user1145141919450/pynq-particle-magnetic-trace/board/README.md

# board/ — 上板包

`deploy/` 内含交付 bit、HWH 与板端运行脚本；复制到板端 `/home/xilinx/wp/` 后按设计报告 §5.1 运行。
