user1145141919450/pynq-particle-magnetic-trace/data/docs/ext_board_schematic.md

# PYNQ-Z2 演示控制拓展板 · 原理图 v1.2

**用途**：把比赛演示需要的外设集中到一块小板上 —— OV5640 摄像头（DVP）与
两个电位器（RV1 调磁场 B → AIN0、RV2 调速度 V → AIN1，共用一颗 PCF8591），
插在 PYNQ-Z2 的 PMOD 与 Arduino 盾板排母上，
**v1.2 修正（2026-09-15，按官方手册 PYNQ-Z2 Reference Manual v1.0 §17 校正）**：
I2C 接盾板 J3 排母第 9/10 针（AR_SDA=P16 / AR_SCL=P15），原 AR6/AR7 是 J4 上
的普通 IO 脚，不能用；A0~A5 经三方对质（手册称 XADC 模拟输入 vs R12 原理图+
官方板卡文件显示现产板为 bank13 普通数字脚、板卡文件无任何 XADC 通道）裁决：
**以现产板为准，A0~A5 不是 ADC，PCF8591 方案不变**。
替代现在的杜邦线飞线。**按键 B+/B- 不用拓展板**：改用板载 BTN0~BTN3
（LED 区下方 4 个板载按键，直通 PL，2026-09-14 用户确认）。

**引脚事实来源**：
- 摄像头 16 根信号：`build/vivado/ov5640_pynq/constrs/ov5640_pynq.xdc`（已上板验证，权威）
- Arduino 排针：Vivado 板卡文件 `pynq-z2/A.0/part0_pins.xml`（AR0~AR13，权威）
- **注意**：板卡文件里 PYNQ-Z2 **没有 XADC 接口**（A0~A5 是普通 LVCMOS33 数字脚），
  故电位器走外置 ADC（PCF8591），不走 XADC。

---

## 1. 系统框图

```
                        拓展板 (ext_board v1.0)
   PYNQ-Z2        ┌─────────────────────────────────────────┐
  ┌─────────┐     │  P1 (JA 插头)  ── D0..D7 ──────────┐     │
  │ PMOD JA │═════│  P2 (JB 插头)  ── pclk/href/vsync │     │
  │ PMOD JB │═════│                ── xclk/rst/pwdn   │     │
  │         │     │                ── scl/sda ────────┼──┐  │
  │ Arduino │     │  P3 (盾板 J3 排母 9/10 针) ─ SDA/SCL ┼─┼──┼─→ U1 PCF8591
  │  盾板区 │═════│                                   │  └─┤     ↑ AIN0←RV1(B)
  └─────────┘     │  J1 摄像头插座(2x9 母) ────────────┘    │     ↑ AIN1←RV2(V)
                  │  18pin OV5640 DVP 模块                  │    10kΩ×2
                  │  供电 3.3V（板载 LDO，已跑通）           │
                  └────────────────────────────────────────┘
   ★ 按键 B+/B- = 板载 BTN1/BTN2（不占拓展板），见 §7
```

## 2. 网络表 —— P1（PMOD JA，摄像头数据）

PMOD 12 针排母定义（Digilent 标准）：pin1~4、7~10 为信号，pin5/11=GND，pin6/12=3V3。

| 拓展板 P1 针 | PYNQ JA 针 | 网络名 | FPGA 球号 | 去向 (J1) |
|---|---|---|---|---|
| 1 | JA1 | DVP_D0 | Y18 | 模块 D0 |
| 2 | JA2 | DVP_D1 | Y19 | 模块 D1 |
| 3 | JA3 | DVP_D2 | Y16 | 模块 D2 |
| 4 | JA4 | DVP_D3 | Y17 | 模块 D3 |
| 5 | — | GND | — | 模块 GND |
| 6 | — | 3V3 | — | 模块 3V3 |
| 7 | JA7 | DVP_D4 | U18 | 模块 D4 |
| 8 | JA8 | DVP_D5 | U19 | 模块 D5 |
| 9 | JA9 | DVP_D6 | W18 | 模块 D6 |
| 10 | JA10 | DVP_D7 | W19 | 模块 D7 |
| 11 | — | GND | — | 模块 GND |
| 12 | — | 3V3 | — | 模块 3V3 |

## 3. 网络表 —— P2（PMOD JB，摄像头控制/时序）

| 拓展板 P2 针 | PYNQ JB 针 | 网络名 | FPGA 球号 | 去向 (J1) |
|---|---|---|---|---|
| 1 | JB1 | DVP_PCLK | W14 | 模块 PCLK |
| 2 | JB2 | DVP_HREF | Y14 | 模块 HREF |
| 3 | JB3 | DVP_VSYNC | T11 | 模块 VSYNC |
| 4 | JB4 | DVP_XCLK | T10 | 模块 XCLK (24MHz) |
| 5 | — | GND | — | 模块 GND |
| 6 | — | 3V3 | — | 模块 3V3 |
| 7 | JB7 | DVP_RST_N | V16 | 模块 RESET |
| 8 | JB8 | DVP_PWDN | W16 | 模块 PWDN |
| 9 | JB9 | DVP_SCL | V12 | 模块 SCL |
| 10 | JB10 | DVP_SDA | W13 | 模块 SDA |
| 11 | — | GND | — | 模块 GND |
| 12 | — | 3V3 | — | 模块 3V3 |

（与 XDC 完全一致：JA1..JA4/JA7..JA10 数据、JB1..JB4/JB7..JB10 控制。
SDA 上拉：FPGA 已开 PULLUP，模块板自带，拓展板可再留 4.7k 焊盘各一，默认不焊。）

## 4. 网络表 —— P3（Arduino 盾板排母区，ADC）

**v1.2 修正（手册 §17 表 16/17 权威值）**：盾板区共 4 排母座——J1（6 针 A0~A5）、
J7（8 针电源 5V/3.3V/GND/RST）、J3（10 针：AR8~AR13 + **第 9 针 AR_SDA=P16、
第 10 针 AR_SCL=P15**）、J4（8 针 AR0~AR7）。**I2C 必须用 J3 第 9/10 针**（板上
丝印 SDA/SCL 就是这俩）；AR0~AR13 其余脚（板卡文件 `arduino_a0_a13_tri_i_0..13`）
都是普通 IO。P16/P15 板卡文件未收录，XDC 用裸球号约束（loc="P16"/"P15"）。

| 拓展板 P3 针 | PYNQ 盾板针位 | 网络名 | FPGA 球号 | 去向 |
|---|---|---|---|---|
| 1 | J3 第 9 针（丝印 SDA） | ADC_SDA | P16 | U1 PCF8591 pin9 (SDA) |
| 2 | J3 第 10 针（丝印 SCL） | ADC_SCL | P15 | U1 PCF8591 pin10 (SCL) |
| 3 | J7 任一 GND 针 | GND | — | 参考地 |

ADC 的 SCL/SDA 上拉：FPGA PULLUP（I2C 速率 ≤100kHz，够用）。
J4 的 AR0~AR7、J3 的 AR8~AR13 留空 —— 日后若要外接长线抓拍按钮可挂这里。
**A0~A5 不用于模拟**：手册 v1.0 称其为 XADC 模拟输入，但 R12 原理图 FPGA 符号与
官方板卡文件一致显示现产板 A0~A5 为 bank13 普通 LVCMOS33 数字脚、板卡文件无
任何 XADC 通道 —— 以现产板为准，电位器走外置 PCF8591，不赌 XADC。

## 5. J1 —— OV5640 模块 18P 插座（2×9 母座）

模块侧 16 根信号 + 3V3 + GND。**排针定义以你的模块丝印/说明为准**，
市面常见两种排法（二选一，画板时照你的模块定）：

排法 A（最常见，VCC 在 1 脚）：
```
 1 VCC3V3    2 GND
 3 SCL       4 SDA
 5 VSYNC     6 HREF
 7 PCLK      8 XCLK
 9 D7        10 D6
11 D5        12 D4
13 D3        14 D2
15 D1        16 D0
17 RESET     18 PWDN
```
排法 B（部分批次，GND 在 1 脚）：
```
 1 GND    2 VSYNC
 3 HREF   4 SCL
 5 SDA    6 PCLK
 7 XCLK   8 RESET
 9 PWDN   10 D0
11 D1     12 D2
13 D3     14 D4
15 D5     16 D6
17 D7     18 VCC3V3
```
判定方法：用万用表通断档量模块板 —— 与电解电容/稳压芯片相连且走线宽的
一根是 3V3；与敷铜大面积相连的是 GND。找到这两根，对照上表即可定排法。

## 6. 电位器 + PCF8591 电路

```
   3V3 ──┬──────────────────────────────┐
         │ (100nF 去耦)                 │
        ─┴─ C1            U1 PCF8591 (DIP16)  A0/A1/A2 全部接地 → I2C 地址 0x48
         │             ┌────────────────┐
   RV1 10kΩ 电位器(B)   │1 AIN0  VDD 16──┤── 3V3
   一端─3V3 一端─GND     │2 AIN1  AOUT 15  │   (空)
   滑动端→AIN0(pin1)     │3 AIN2  VREF 14──┤── 3V3 (满量程基准)
   RV2 10kΩ 电位器(V)   │4 AIN3  AGND 13──┤── GND
   接法同 RV1            │5 A0    EXT 12───┤    (空)
   滑动端→AIN1(pin2)     │6 A1    OSC 11───┤    (空)
                        │7 A2    SCL 10───┼── ADC_SCL → P3 针2
                        │8 VSS   SDA 9────┼── ADC_SDA → P3 针1
                        └────────────────┘
   AIN2~AIN3 留焊盘（日后可加钮）
   I2C 速率 ≤100kHz；VREF=VDD=3.3V → 满量程 0~3.3V，8 位 256 级，调 B/V 足够。
```

## 7. 按键（板载 BTN0~BTN3，不在拓展板上）

PYNQ-Z2 板载 4 个按键（LED 区）直通 PL，无需任何外部器件（板卡文件权威值）：

| 按键 | FPGA 球号 | 电平 | 本设计用途 |
|---|---|---|---|
| BTN0 | D19 | 按下=高 | 抓拍键（原设计已定） |
| BTN1 | D20 | 按下=高 | **B+（磁场增强，每按一次加一档）** |
| BTN2 | L20 | 按下=高 | **B-（磁场减弱，每按一次减一档）** |
| BTN3 | L19 | 按下=高 | 备用（如 B 归零/清轨迹） |
| SW0 | M20 | 拨=高 | 备用（如：电位器/按键选源） |
| SW1 | M19 | 拨=高 | 备用 |

注意：板载按键**按下=高电平**（板上有上拉网络，XDC 无需 PULLUP）；
PL 侧 2-FF 同步 + 20ms 消抖 + 上升沿触发。演示时板子放在手边即可单手按 BTN1/2。

## 8. BOM

| 位号 | 元件 | 规格 | 数量 | 备注 |
|---|---|---|---|---|
| U1 | PCF8591 | I2C 8bit ADC，DIP16 | 1 | 或 SOP16 转接 |
| RV1 | 电位器（调 B） | **Bourns PTV09A-4015F-B103**（或 -4020U-B103） | 1 | B 型线性 10kΩ；4015/4020=柄长 15/20mm，两者皆可 |
| RV2 | 电位器（调 V） | **Bourns PTV09A-4015F-B103**（或 -4020U-B103） | 1 | 同上。**选型要点：B 型=线性**（A 型对数不可用于调参数量）；103=10kΩ；到货用万用表验：中点≈总阻值一半 |
| C1 | 去耦电容 | 100nF | 1 | |
| P1/P2 | 排针插头（对插 PMOD） | 2×6 弯针公头 | 2 | 方向按实物定 |
| P3 | 排针插头 | 1×3 弯针公头（或杜邦线座） | 1 | SDA/SCL/GND |
| J1 | 摄像头插座 | 2×9 母座（或直接焊杜邦线座） | 1 | 2.54mm |
| R1/R2 | 上拉电阻焊盘 | 4.7kΩ | 2 | 默认不焊（见 §3） |

（按键不在 BOM 里 —— 用板载 BTN0~BTN3，见 §7。）

## 9. 设计说明与注意事项

1. **共地**：P1/P2/P3 的 GND 在拓展板上必须连成一个地平面；按键与 ADC 都
   参考这个地。
2. **供电**：摄像头 3V3 取自 PMOD（现状已跑通，模块板载 LDO）；
   ADC+电位器 3V3 同样取自 PMOD 3V3（电流 <1mA，无压力）。
3. **XADC 说明**：部分批次 PYNQ-Z2 的 A 区脚可能有 XADC 辅通道（论坛有
   A5→VAUX13 的讨论），但官方板卡文件未声明、不可依赖。本设计不赌它；
   若日后想验证，可在拓展板留一个 A0 测试点（不影响本设计）。
4. **物理可分**：摄像头部分（P1/P2/J1）与 ADC 部分（P3/PCF8591/RV）电气完全独立——摄像头只占 PMOD、ADC 只占 Arduino 排针。两种实物做法等效：①一体板（本原理图，含摄像头插座+ADC）②分开（摄像头维持已验证杜邦线不动 + 电位器/PCF8591 单独面包板或洞洞板），接线表不变。
5. **后续实现（PL/PS 侧，M1b 阶段做）**：
   - ADC：在 PL 再例化一个 I2C 主机（复用已验证的 `ov5640_iic.v`，挂在
     AR7/AR6），按固定节拍读 PCF8591 通道 0（B）与通道 1（V）→
     两个 32 位寄存器 → axi_gpio → PS。
   - 按键：板载 BTN0~BTN3 直通 PL（D19/D20/L20/L19，按下=高），2-FF 同步 +
     20ms 消抖 + 上升沿 → axi_gpio → PS；XDC 用板卡预设、LVCMOS33。
   - 演示逻辑：BTN0=抓拍；BTN1/BTN2 按一次 B 加/减一档（长按可连续加）；
     电位器值 + 按键增量共同决定 B 的设定值（B = clamp(B_base + pot_delta +
     Σ按键步进)）。
