user1145141919450/pynq-particle-magnetic-trace/data/README.md

# data/ — 数据与原始报告

- `docs/`：构建/迁移、演示、规则等项目文档；
- `reports/`：净室构建、板上验收等实测报告；
- `evidence/`：交付 bit 与 2026.1 迁移 bit 的原始时序/资源 .rpt；
- `captures/`：实拍采集数据。
