user1145141919450/pynq-particle-magnetic-trace/sim/README.md

# sim/ — 仿真

`tb/` 含 13 个 testbench；`run_v3_sim.sh` / `run_map_detect_sim.sh` 可直接运行；详细对拍口径见设计报告 §3.1。
