user1145141919450/pynq-particle-magnetic-trace/report/photos/README.md

# photos/ —— 报告用图与原始照片

## 报告用图

| 文件 | 用在 |
|---|---|
| `seewo_fig.jpg` | 图 1 课堂演示（希沃大屏） |
| `props_wide.jpg` | 图 3 实体摆件（横向） |
| `serial_pair.jpg` | 图 4 串口屏（(a) 状态页 + (b) 加球选色页） |
| `serial_hmi_editor.jpg` | 图 5 串口屏开发界面（USART HMI） |
| `hdmi_fig.jpg` | 图 6(a) HDMI 实拍叠加与轨迹 |
| `web_fig.png` | 图 6(b) 平板网页对局页（原生截图） |
| `hardware_montage_fig.jpg` | 图 7 硬件模块（摄像头转接板/照明/MTT USB 坞，键鼠/网卡） |
| `vivado_bd.pdf` | 完整 Vivado BD（矢量，可放大） |

## 原始照片

| 文件 | 内容 |
|---|---|
| `seewo.png` | 希沃课堂演示原图 |
| `setup_wide.jpg` | 桌面全景（键鼠、平板、串口屏、实体件） |
| `props_closeup.jpg` | 实体摆件原图 |
| `serial_status.jpg` / `serial_addball.jpg` | 串口屏状态页 / 加球选色页原图 |
| `hdmi_screen_crop.jpg` / `web_ui_crop.jpg` | HDMI 画面 / 平板网页裁图 |
| `camera_adapter.jpg` | OV5640 摄像头转接板 |
| `lighting_module.jpg` | 照明模块（相机补光） |
| `usb_hub.jpg` | MTT USB 扩展坞 |

照片只用于作品说明，不含个人信息或凭据。

## 2026-11-02 新增（图 5、图 6）

| 文件 | 内容 |
|---|---|
| `hdmi_new.jpg` | HDMI 屏幕实拍原图（新） |
| `web_new.png` | 平板网页对局页截图（新，原生分辨率） |
| `serial_hmi_editor.jpg` | 图 5 串口屏 USART HMI 编辑界面（1400×836） |
| `hdmi_fig.jpg` | 图 6(a) HDMI 裁切图（1070×580） |
| `web_fig.png` | 图 6(b) 平板网页图（1280×889，未缩放） |
| `serial_pair.jpg` | 图 4 串口屏两联图（状态页 + 加球选色页） |
| `run_small.jpg` / `run_raw_new.jpg` | 旧版图 6 两联图（已不再引用，仅存档） |
