user1145141919450/pynq-particle-magnetic-trace/data/docs/demo_script_3min.md

# 三分钟台本 · 2026-10-31 晚

> ⚠ **上镜前必做**：本文里的 6.7ms / 1.6s / 240× 是旧稿数字，与板上另一次实测
> （6.09ms / 1427ms / 234×）不一致。**开拍前用当时那块 bit 重测一次，全套数字统一**
> 用那一轮的结果，再回来改本文。说错数字比说漏更糟。
> 重测命令（板上）：`./v3_shoot.sh --cam`（读它打印的 PL 一簇耗时与 PS 串行耗时）。

---

## 开场前摆好（不上镜的部分）

- 红球、蓝球各一颗，放在桌边（换球用）
- 黑条一根、绿门两扇、黑球一个，**开局就摆在场区里**（它们是"免费基线"，不用买不用摆）
- 手机架好、串口屏朝镜头

---

## 台本

**[0:00]** （手里拿着球）

这个球，我们当成带电粒子。

（把球放到桌上）

放上去，它一停稳，屏幕上就把它圈出来、编号。这一步是相机识别，还没到 FPGA。

**[0:15]** （指着屏幕）

这条绿线是我瞄的方向。旁边这一排小点，是 17 条轨迹各自的结局——绿的能从这个洞出去，灰的打回来了。

（按空格）

走。

（等）

进了。屏幕上这一下，是 17 条路**同时**算出来的，在一块 FPGA 上，6.7 毫秒。

同样这 17 条，CPU 一条一条算，要 1.6 秒。差 240 倍。

而且不是"看起来对"：这 17 条结果，跟我们自己的软件模型逐条对过，一条不差。

**[0:50]** 再打一枪，这次故意偏一点。

（按空格）

你看，没进，打回来了。那些灰点就是撞墙回来的——17 条各算各的，才有这一绿一灰的区别。

**[1:05]** （换蓝球进场）

下面这个我们最喜欢。红的是正的，蓝的是负的。

（红蓝各打一颗，让它们对撞）

等它们撞上——（等）——看，一起没了。正负相消，闪个白圈。

这是规则里写的物理，不是特效。

**[1:30]** （指场上的黑条、绿门、洞口）

场上我已经摆好了黑条、一对绿门、一个洞口。

（打一杆）

球撞黑条弹开，进绿门从另一头出来，最后从这个新洞口出射。

障碍、传送门、洞口——一杆全过。

**[1:50]** （切到局前商店）

道具是买的，五种，用积分买。

（选一个，按 E）

买了，积分少一截。买完现场摆，**确认才生效，不确认不扣**。

**[2:10]** （改磁场，连改两次）

磁场也能改：选块、定方向、输数值，三步确认。

（改第一次）

改一次，它重算一次 17 条。

（改第二次）

再改一次，又重算一次。每次 6.7 毫秒——你改多快它算多快。

**[2:40]** （收）

所以这个东西就两件事：

**算**，在一块 FPGA 上，17 条路同时算，6.7 毫秒，跟软件逐位对得上；

**玩**，它是一副两个人能坐下来打的游戏，有积分、有道具、有洞口。

就这些。

---

## 怎么演（镜头纪律）

| 段落 | 镜头 | 忌讳 |
|---|---|---|
| 放球 | 手 + 桌子，别拍屏幕 | 别一上来就怼屏幕 |
| 打杆 | 屏幕，**等判定出现**再开口 | 别边打边说话，评委听不清 |
| 多球 | 屏幕，等湮灭那一下 | **别现场试角度**，排练时定好 |
| 一杆多效 | 屏幕 + 手（摆好了不用手） | 别在这段解释道具怎么买 |
| 商店 | 屏幕特写 | 别念菜单 |
| 改磁场 | 键盘手部 + 屏幕（同框） | 别背对镜头挡屏 |

---

## ⚠ 开拍前必须核实的三条（核完再定稿）

1. **数字统一**：跑 `./v3_shoot.sh --cam`，把 PL 一簇耗时 / PS 串行耗时 / 倍数
   记下来，全文换成这一轮的实数（现稿 6.7ms/1.6s/240× 与板上另一次实测
   6.09ms/1427ms/234× 不一致，不能就这么说）。
2. **场区到底有什么**：默认场区种子（seed 7）自带「3 块磁场 + 左右两洞」，而
   [1:30] 写的是「我摆了一根黑条、一对绿门、一个洞口」。**实跑一眼看屏幕**，
   按屏幕上真实出现的件数与位置改这段——说错件数比少说更糟。
   看启动那行 `[V3] 场区：块=? 洞=[...]`，以及屏幕上实际画出的障碍/门/洞。
3. **黑条/绿门/洞口是不是开局就免费**：源码里写的是"开局就在桌上的实体件是免费
   基线，不受购买门限制"，但**要在板上实跑确认**（尤其洞口）。

---

## 排练必须解决的三件事

1. **进洞那一杆的角度**：提前找到能进的那一枪，写下来（角度/球位），现场照打
2. **红蓝对撞的角度**：两颗球要能撞上，排练时试出来
3. **连改磁场的手速**：两次改动之间别停超过 3 秒，让评委看到"改一次算一次"

---

## 卡住了就说的三句

- 球没识别：「它要停稳才发号」→ 拿起来再放下
- 画面卡：「卡的是摄像机画面，计算从来没卡过——6.7 毫秒」
- 按错：「三步确认，每一步都能退」→ `ESC`

---

## 如果只剩 60 秒

打一杆（进洞）+ 多球湮灭 + 一句收口：

> 「17 条路同时算，6.7 毫秒，比 CPU 快 240 倍，跟软件逐位对得上；它还是个能打的游戏。」
