user1145141919450/pynq-particle-magnetic-trace/data/docs/project_intro_2026-10-25_final.md

# 项目介绍（2026-10-25 定稿）

> **用户定稿：这段文字不再改动。**
> 字数实测：**含换行/空行 495 字，不含换行 489 字**（≤500）。
> 对外介绍按正文；正文没展开的分工与边界见文末“答辩口径”。

本项目基于PYNQ搭建双人对抗式粒子磁迹演示装置，聚焦带电粒子磁场偏转、临界出射与多电荷交互规律。系统通过摄像头映射实体桌面与虚拟磁场，两名玩家可调节粒子入射速度、角度与分块磁场参数，操控正负电子射出边界缺口完成得分。

本项目核心优势为FPGA硬件并行，区别于单片机、软件仿真的串行迭代模式，采用多路硬件几何运算流水线，并行完成17路轨迹束与障碍/门判定；系统另集成8粒PL粒子引擎，演示多体碰撞与电荷交互，实现同种电荷反弹、异种电荷湮灭与实体碰撞。轨迹束求解与判定一次完成，系统真实还原多粒子耦合过程。

用户可现场摆放实体件自定义地形，红球为正电荷、蓝球为负电荷、黑球为洞口标记，黑条反射障碍、绿椭圆传送门，形成出题、对抗、复盘的完整教学闭环，并搭配串口屏、HDMI与手机端实时反馈。系统采用梯度关卡、逐局增加分区与积分兑换道具。HDMI实时叠加17路瞄准轨迹束与真球轨迹，串口屏与手机端同步对局参数；PL轨迹束一次扫描17路微扰，直观呈现临界分界。

采用PS/PL异构，PL完成候选检测、17路轨迹束与障碍/门判定，集成8粒粒子引擎；ARM负责对战逻辑、积分道具、交互与候选复判。

---

## 答辩口径（正文没写的，被问再答）

- **主对局多球碰撞/异种电荷湮灭在 PS** `realtime_ball`；PL 负责 17 路轨迹束、候选检测、障碍/门判定与 16 粒 PL 粒子引擎（可选/风暴演示）。
- **classify 仍在 PS**；只说“PL 出候选”，**不说“整条检测链在 PL”**。
- **17 路轨迹束当前是 2 条物理 lane 时间复用**，相对 PS 串行约 **22×**（534ms→~24ms）；不说“17 路并行硬件”。
- **HDMI 默认去 HUD**（`SCREEN=1` 默认 `--no-hud`）；参数在串口屏/手机；需要 HDMI 参数可 `HUD=1`。
- **没有 LED 灯光**；反馈是串口状态屏 + HDMI 画面 + 手机端。
- **“复盘”是能力**：进球会生成 6s 复盘图（`--v3-review`），手机有最近一杆/轨迹；平时不常放，答辩按能力说，不现场承诺展示复盘图。
