user1145141919450/pynq-particle-magnetic-trace/report/photos/camera_adapter.jpg

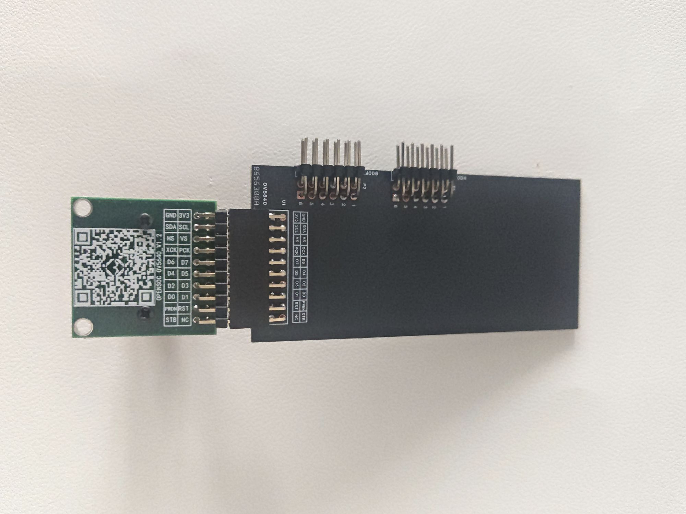
report/photos/camera_adapter.jpg
