user1145141919450/pynq-particle-magnetic-trace/report/photos/hdmi_new.jpg

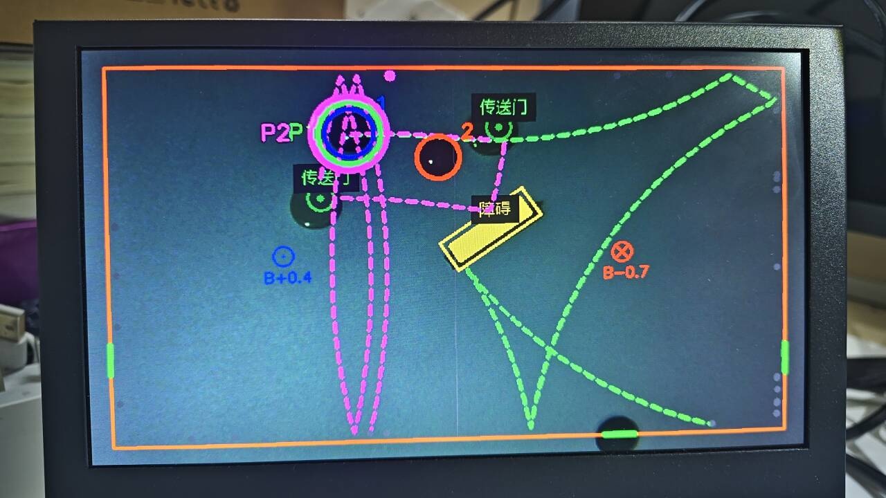
report/photos/hdmi_new.jpg
