user1145141919450/pynq-particle-magnetic-trace/report/photos/hdmi_screen_crop.jpg

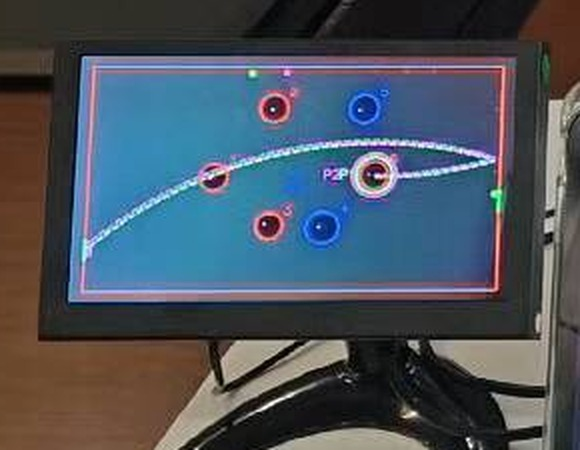
report/photos/hdmi_screen_crop.jpg
