user1145141919450/pynq-particle-magnetic-trace/report/photos/lighting_module.jpg

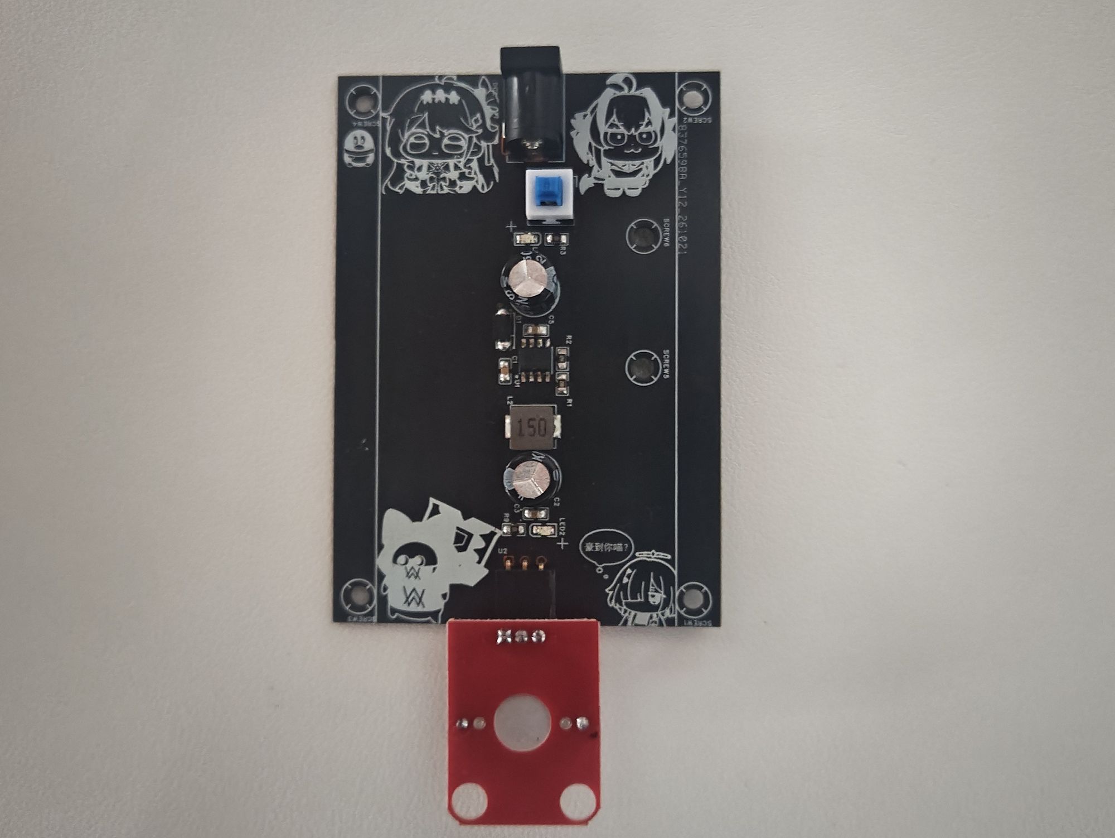
report/photos/lighting_module.jpg
