user1145141919450/pynq-particle-magnetic-trace/report/photos/props_closeup.jpg

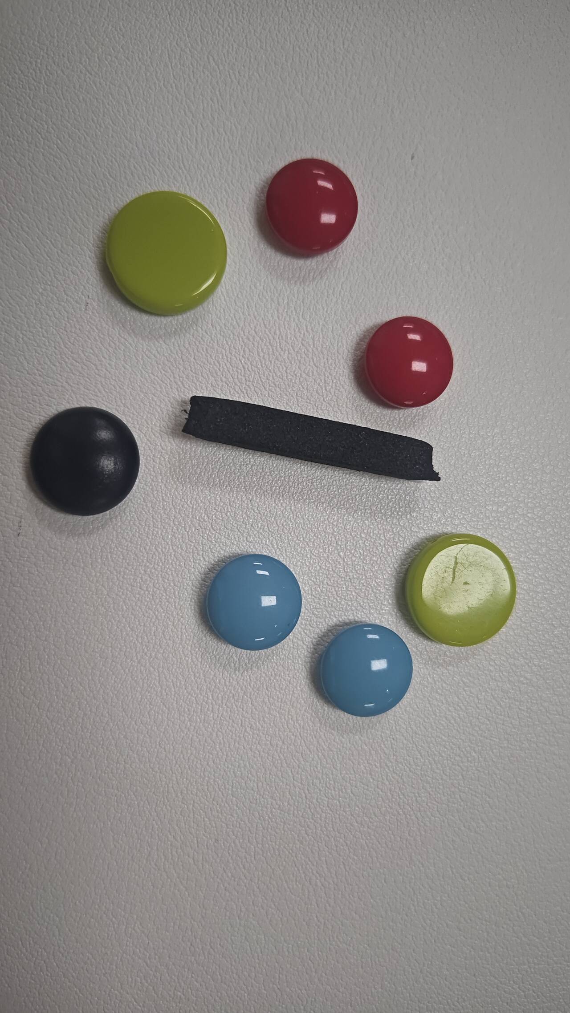
report/photos/props_closeup.jpg
