user1145141919450/pynq-particle-magnetic-trace/report/photos/props_full.jpg

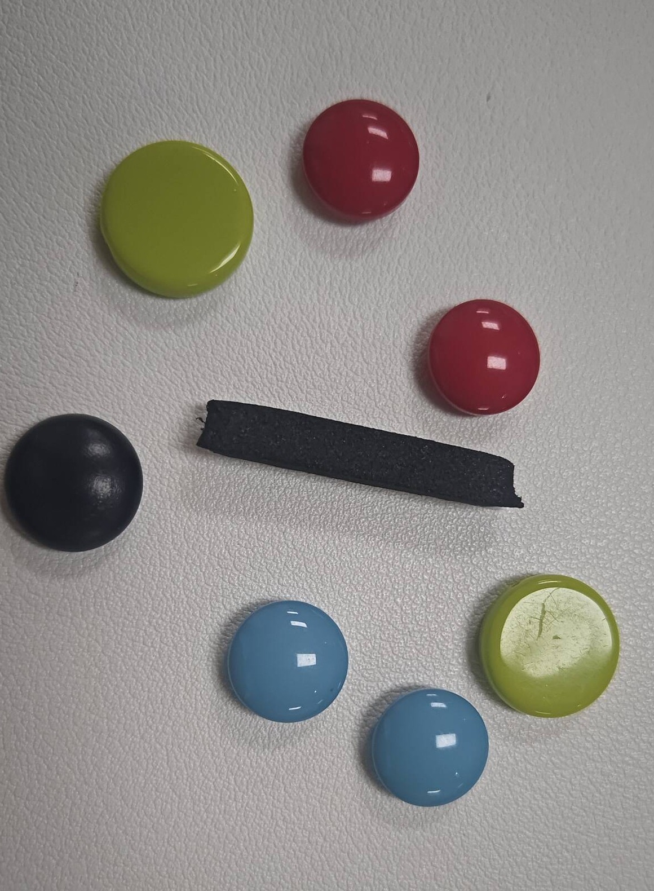
report/photos/props_full.jpg
