user1145141919450/pynq-particle-magnetic-trace/report/photos/run_raw_new.jpg

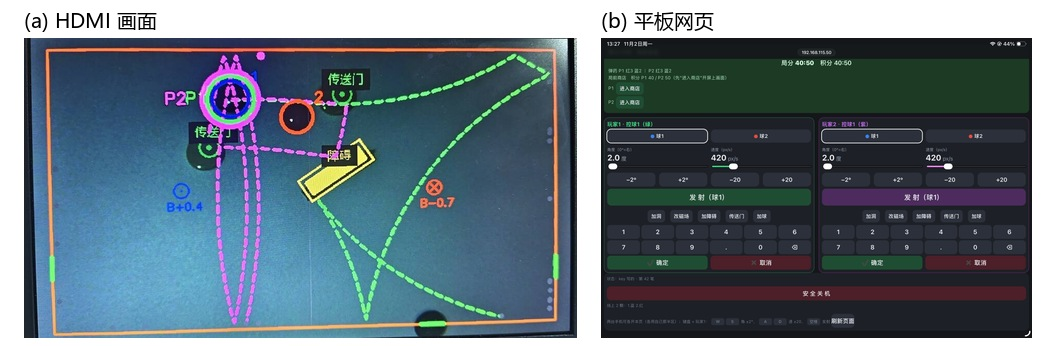
report/photos/run_raw_new.jpg
