user1145141919450/pynq-particle-magnetic-trace/report/photos/serial_addball.jpg

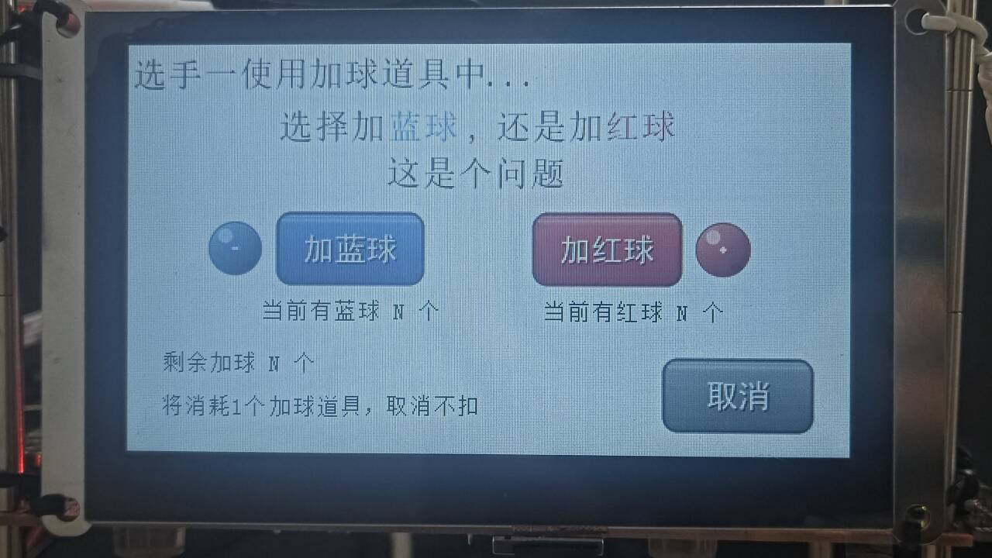
report/photos/serial_addball.jpg
