user1145141919450/pynq-particle-magnetic-trace/report/photos/serial_status.jpg

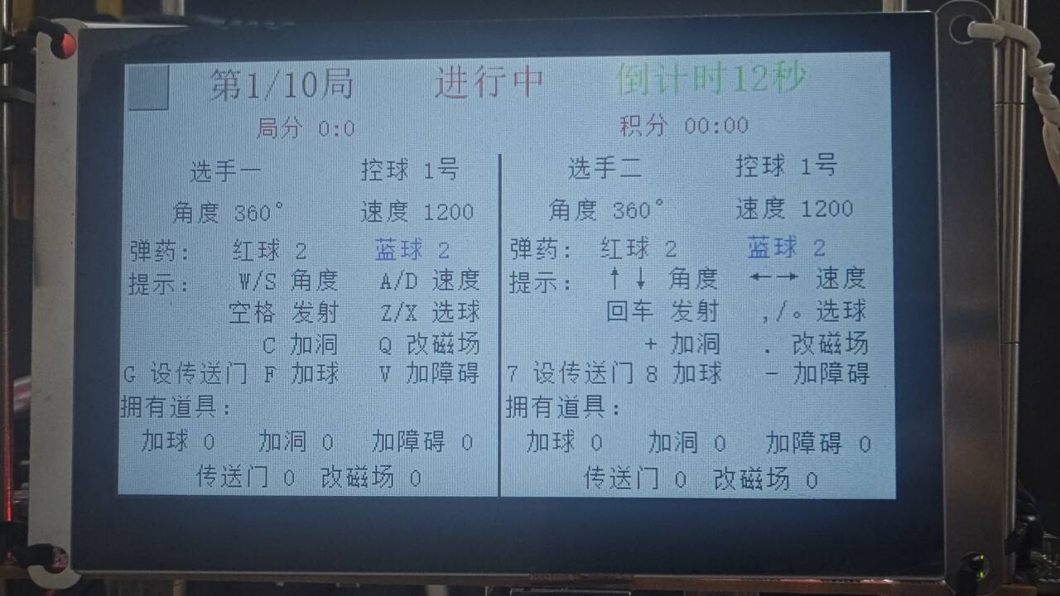
report/photos/serial_status.jpg
