user1145141919450/pynq-particle-magnetic-trace/report/photos/serial_status_small.jpg

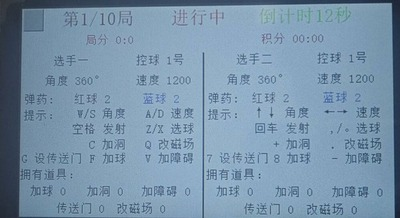
report/photos/serial_status_small.jpg
