user1145141919450/pynq-particle-magnetic-trace/report/photos/usb_hub.jpg

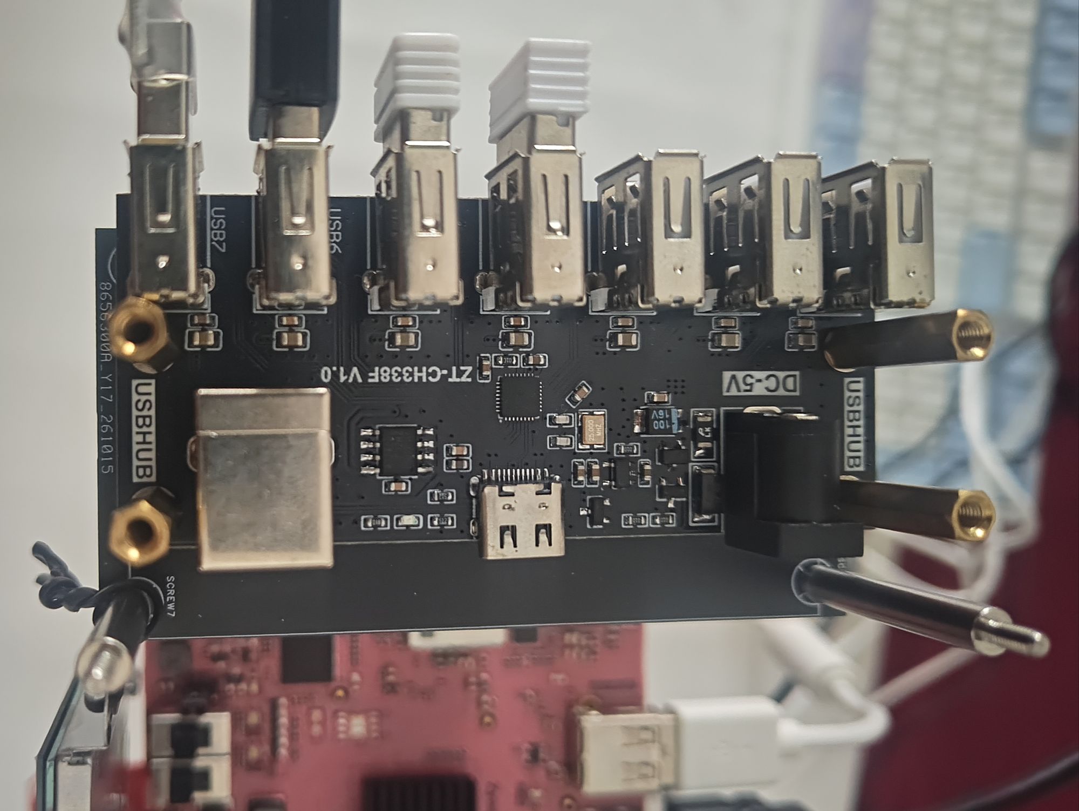
report/photos/usb_hub.jpg
