user1145141919450/pynq-particle-magnetic-trace/report/photos/web_ui_crop.jpg

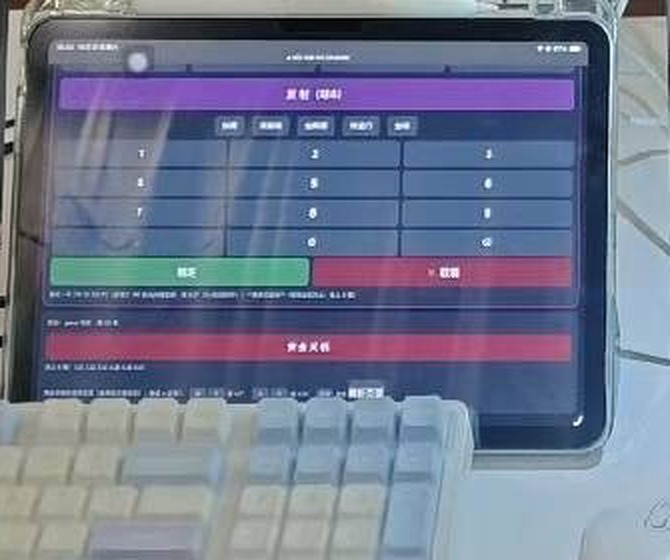
report/photos/web_ui_crop.jpg
