user1145141919450/pynq-particle-magnetic-trace/build/README.md

# build/ — 可复现构建快照

从 `build/vivado/ov5640_pynq/` 运行 Vivado Tcl；构建后在包根执行 `python build/tools/finish_build.py`。
`build/software/`、`build/game_pc/` 是构建验收脚本使用的源码副本。
