user1145141919450/pynq-particle-magnetic-trace/build/software/captures/runs.csv

event | time | P0x | P0y | vx | vy | speed | theta | B | turning | verdict | r | exit_x | exit_y
snap | 17:16:38 | 400.0 | 320.2 | 18.75 | -5.31 | 19.49 | -15.82 | 1.00 | 1 | return | 97.4 | 400.0 | 132.8
snap | 17:16:47 | 400.0 | 339.2 | 19.65 | -6.17 | 20.60 | -17.44 | 1.00 | 1 | return | 103.0 | 400.0 | 142.7
snap | 17:16:53 | 400.0 | 304.5 | 23.24 | 5.10 | 23.79 | 12.37 | 1.00 | 1 | exit | 119.0 | 505.2 | 100.0
verdict | 17:16:59 | 400.0 | 304.5 | 23.24 | 5.10 | 23.79 | 12.37 | 1.20 | 1 | return | 99.1 | 400.0 | 110.8
snap | 17:17:07 | 400.0 | 350.9 | 13.93 | -6.94 | 15.57 | -26.48 | 2.35 | 1 | return | 33.1 | 400.0 | 291.6
snap | 17:17:17 | 400.0 | 334.6 | 17.10 | 0.81 | 17.12 | 2.72 | 2.35 | 1 | return | 36.4 | 400.0 | 261.8
snap | 17:17:32 | 400.0 | 330.3 | 15.23 | -0.86 | 15.26 | -3.22 | 0.27 | 1 | exit | 282.5 | 580.0 | 251.8
snap | 17:29:23 | 400.0 | 280.4 | 24.83 | 1.12 | 24.86 | 2.57 | 1.00 | 1 | exit | 124.3 | 516.4 | 100.0
verdict | 17:29:33 | 400.0 | 280.4 | 24.83 | 1.12 | 24.86 | 2.57 | 1.37 | 1 | critical | 90.7 | 404.1 | 100.0
verdict | 17:29:34 | 400.0 | 280.4 | 24.83 | 1.12 | 24.86 | 2.57 | 1.39 | 1 | return | 89.4 | 400.0 | 101.8
verdict | 17:29:38 | 400.0 | 280.4 | 24.83 | 1.12 | 24.86 | 2.57 | 1.37 | 1 | critical | 90.7 | 404.1 | 100.0
verdict | 17:29:39 | 400.0 | 280.4 | 24.83 | 1.12 | 24.86 | 2.57 | 1.39 | 1 | return | 89.4 | 400.0 | 101.8
verdict | 17:29:40 | 400.0 | 280.4 | 24.83 | 1.12 | 24.86 | 2.57 | 1.37 | 1 | critical | 90.7 | 404.1 | 100.0
verdict | 17:29:41 | 400.0 | 280.4 | 24.83 | 1.12 | 24.86 | 2.57 | 1.39 | 1 | return | 89.4 | 400.0 | 101.8
verdict | 17:29:46 | 400.0 | 280.4 | 24.83 | 1.12 | 24.86 | 2.57 | 1.37 | 1 | critical | 90.7 | 404.1 | 100.0
verdict | 17:29:46 | 400.0 | 280.4 | 24.83 | 1.12 | 24.86 | 2.57 | 1.33 | 1 | exit | 93.4 | 438.2 | 100.0
verdict | 17:29:48 | 400.0 | 280.4 | 24.83 | 1.12 | 0.00 | 0.00 | 0.00 | 1 | invalid | 0.0
verdict | 17:29:49 | 400.0 | 280.4 | 24.83 | 1.12 | 24.86 | 2.57 | 0.02 | 1 | exit | 6213.8 | 580.0 | 285.9
verdict | 17:29:51 | 400.0 | 280.4 | 24.83 | 1.12 | 24.86 | 2.57 | 1.37 | 1 | critical | 90.7 | 404.1 | 100.0
verdict | 17:29:51 | 400.0 | 280.4 | 24.83 | 1.12 | 24.86 | 2.57 | 1.45 | 1 | return | 85.7 | 400.0 | 109.1
verdict | 17:29:54 | 400.0 | 280.4 | 24.83 | 1.12 | 24.86 | 2.57 | 1.37 | 1 | critical | 90.7 | 404.1 | 100.0
verdict | 17:29:59 | 400.0 | 280.4 | 24.83 | 1.12 | 24.86 | 2.57 | 1.35 | 1 | exit | 92.1 | 429.7 | 100.0
verdict | 17:30:00 | 400.0 | 280.4 | 24.83 | 1.12 | 24.86 | 2.57 | 1.37 | 1 | critical | 90.7 | 404.1 | 100.0
verdict | 17:30:01 | 400.0 | 280.4 | 24.83 | 1.12 | 24.86 | 2.57 | 1.39 | 1 | return | 89.4 | 400.0 | 101.8
