user1145141919450/pynq-particle-magnetic-trace/report/photos/setup_wide.jpg

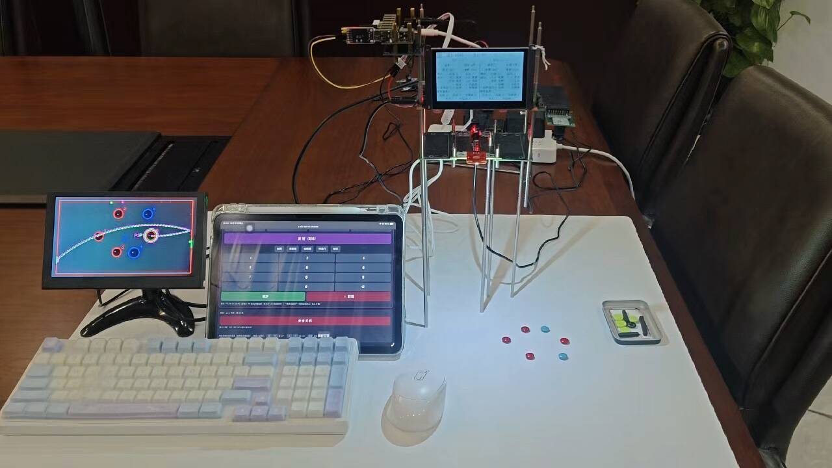
report/photos/setup_wide.jpg
