user1145141919450/pynq-particle-magnetic-trace/report/photos/vivado_bd.pdf

## TMDS_out

slowest_sync_clk ext_reset_in mb_reset bus_struct_reset[0:0] peripheral_reset[0:0] aux_reset_in mb_debug_sys_rst dcm_locked interconnect_aresetn[0:0] peripheral_aresetn[0:0] | axi_dynclk S_AXI_LITE REF_CLK_I PXL_CLK_O PXL_CLK_5X_O s_axi_lite_aclk LOCKED_O s_axi_lite_aresetn

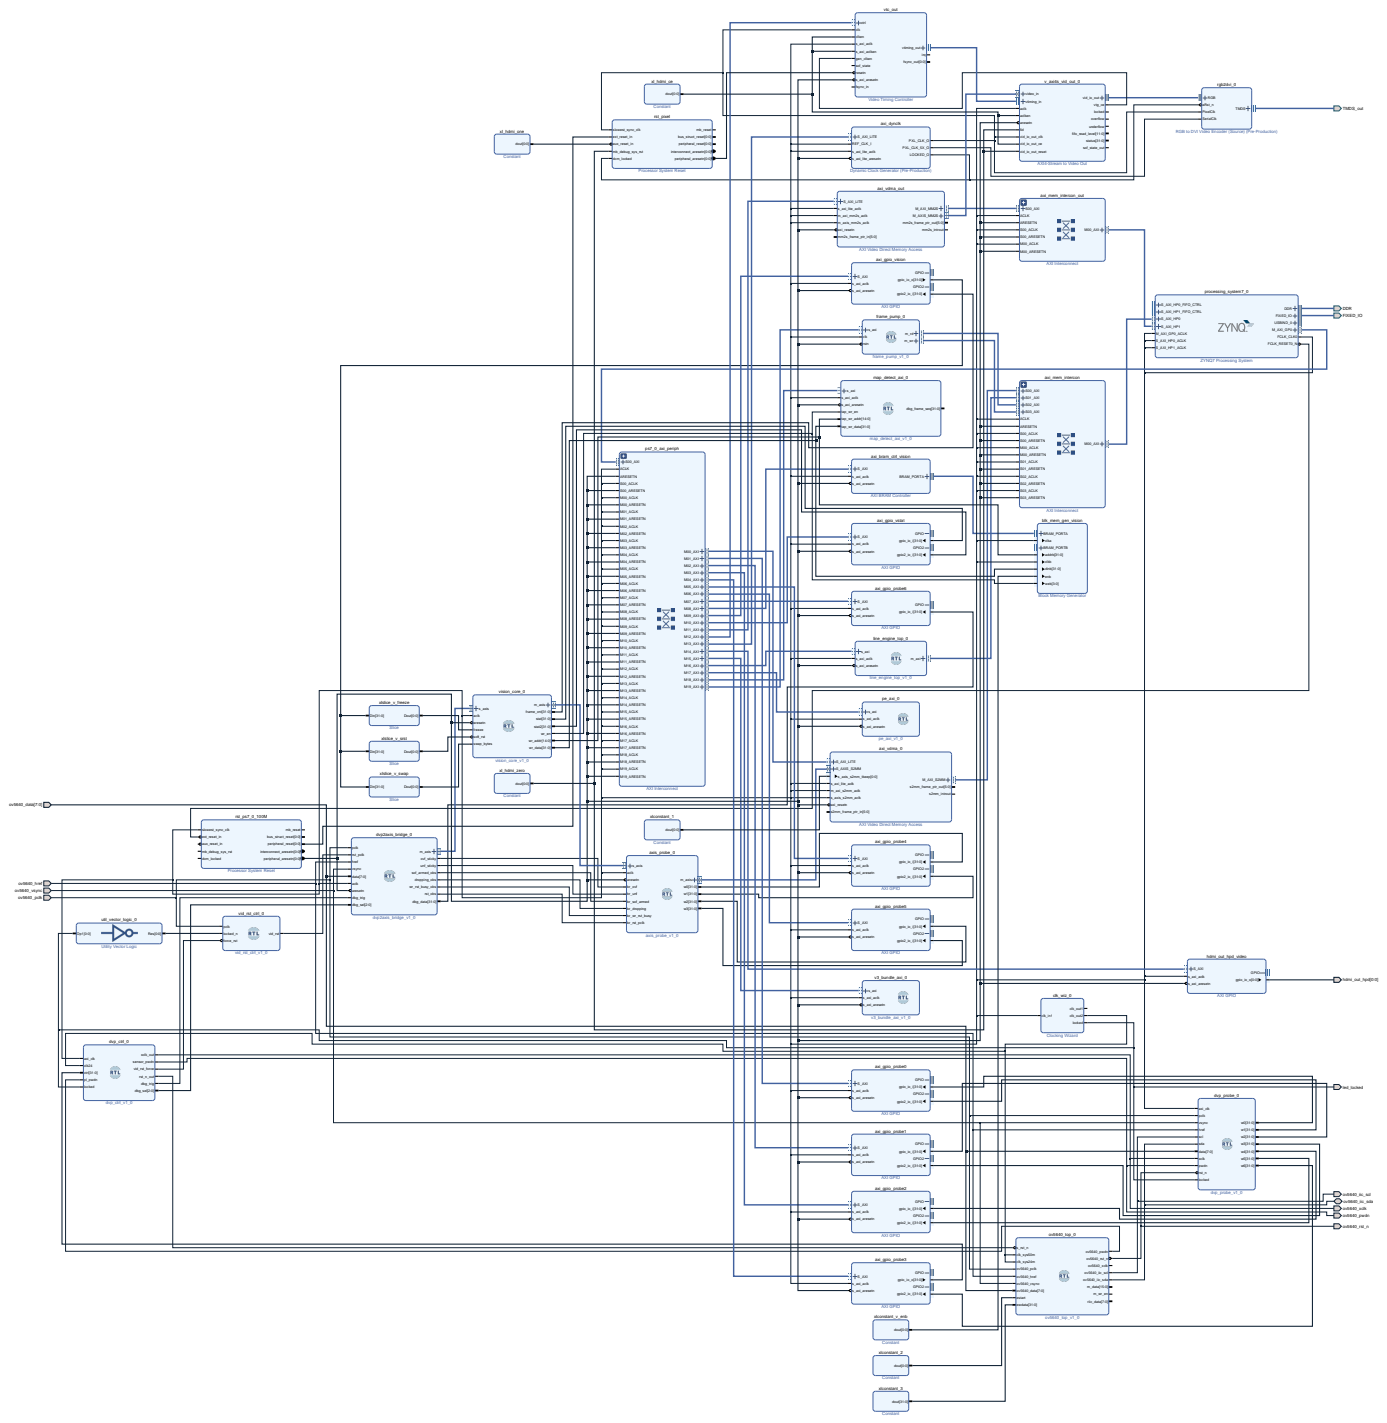
[picture p25: page 1]
DDR FIXED_IO; axi_bram_ctrl_vision; S_AXI s_axi_aclk; BRAM_PORTA; s_axi_aresetn; axi_gpio_probe0; AXI GPIO; S_AXI; GPIO; gpio_io_i[31:0] GPIO2; gpio2_io_i[31:0]; s_axi_aclk; axi_gpio_probe1; axi_gpio_probe2; axi_gpio_probe3; gpio_io_o[31:0] GPIO2; axi_gpio_probe4; axi_gpio_probe5; axi_gpio_probe6; gpio_io_i[31:0] s_axi_aclk; axi_gpio_vision; axi_gpio_vstat; axi_mem_intercon; AXI Interconnect; S00_AXI; M00_AXI; S01_AXI S02_AXI S03_AXI ACLK; ARESETN; S00_ACLK; S00_ARESETN M00_ACLK M00_ARESETN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

Video Timing Controller

RGB to DVI Video Encoder (Source) (Pre-Production)

AXI4-Stream to Video Out

Processor System Reset

Dynamic Clock Generator (Pre-Production)

AXI Video Direct Memory Access

AXI BRAM Controller

dinb[31:0] enb web[3:0]

Block Memory Generator

dvp2axis_bridge_0
rst_pclk href vsync data[7:0] aclk aresetn

Utility Vector Logic

axi_clk pclk
vsync href scl sda

data[7:0] xclk pwdn
