user1145141919450/pynq-particle-magnetic-trace/board/deploy/ball_game.py

# -*- coding: utf-8 -*-
"""ball_game.py — V3 原型：**真正的游戏循环**（读缩略图 -> 找球 -> 追轨迹 -> 出状态）。

为什么现在做它（2026-09-27 下午）：V2 已经把"缩略图能找到球、与全分辨率差 <=8px"
验证过了（白纸 16/16 帧、木纹杂背景 10/11 帧），**该往前走了** —— 演示要的是
"每帧知道球在哪、往哪走、画出轨迹"，而不是再调检测器。

它同时是**链路长跑测试**：游戏循环就是"30fps 连续采集"，跑几分钟正好量出
"自愈阶梯（脉冲 -> 传感器断电重上电）能不能把它撑住" —— 演示现场没有人手跑
stall_probe，撑得住才叫能用。

用法（板上）：
  python3 /home/xilinx/wp/ball_game.py --sec 120 [--nobit] [--render 30] [--trail 60]
    --sec S     跑 S 秒（默认 60）
    --render K  每 K 帧存一张叠加图到 /home/xilinx/wp/game_d.png（默认 0=不存）
    --trail N   轨迹保留最近 N 个点（默认 60）
    --no-bg     不用背景差分（默认有背景就自动用）
    --max-r P   球半径上限（px，默认 320）

  ★ P1：V3 实时预测（2026-09-28 深夜加；**不给 --v3 时行为一个字节都不变**）
    --v3 K        每 K 个**有效帧**（真的找到球的那种）拿当前球位喂一次 V3，
                  当场画出那一簇 17 路的判定，覆盖写 --v3-dump（默认 0 = 不预测）
    --v3-seed S   场区种子（默认 7，与定妆照同一套：3 块磁场 + 左右两洞）
    --v3-b B      固定 |B|（默认 0.40，符号隔块翻转）
    --v3-fan F    扇形半宽（默认 12°）
    --v3-steps N  积分步数（默认 600 ≈ 2.5s，够画出射；越大折线越贵）
    --v3-angle A  入射角（默认 0.0° = **右水平**；逆时针为正、360° 一圈；
                  2026-10-28 起是绝对角度，不再是"边法线相对角"）
    --v3-speed V  入射速度（默认 400 px/s；给 0 = 改用跟踪出来的速度）
    --v3-track-angle  入射角也改用跟踪出来的方向（原型模式）
    --v3-no-arcs      只给临界那条画弧线（省 ~150ms/次，图上其余路只剩终点小点）
    --v3-dump F   预测图文件名（默认 v3_live.png，写在工作目录）
    --v3-hdmi     ★ P2：把 V3 每次预测画的图**直接推到板载 HDMI**（接显示器用）。
                  只上屏、不写盘 —— 配 --v3-dump none 就是"零写盘直出"现场档。
                  帧泵启动失败会自己关掉，游戏照跑；**不给它时行为一个字节都不变**。
    --v3-hdmi-live ★ 直播档（2026-10-01 夜加；**必须配 --v3-hdmi**）：屏幕不再是
                  "每次预测换一张仿真图"（stst 换帧一闪一闪、且看不到实拍），改成
                  **单缓冲原地写、DMA 全程不停** —— 每个循环抓一张原图（~15ms），
                  叠上场区边界/洞口/球圈/轨迹直推上屏：**屏幕 = 摄像头实拍 + 跟踪
                  叠加，不闪不黑**。配 --v3-review：每次"这一杆会进洞"（扇形正中
                  那一路 = 球员瞄的角度，判定=goal）-> 屏幕切到该次的轨迹复盘图
                  review 秒，然后自动回直播。不给它时行为一个字节都不变。
    --v3-review S  直播档里"进球复盘图"停留的秒数（默认 6.0；只在 --v3-hdmi-live
                  下生效；给 0 = 关掉复盘）。触发 = 正中那一路 goal 的**上升沿**。
    --track-margin P  ★ 追踪只认场区内的球：候选球心的游戏坐标要落在场区外扩 P
                  像素的框里（默认 20）。场外的大块（手机支架/黑色网线）从此不再
                  抢目标。只在 --v3 开启时生效（要场区+标定）；不开 --v3 行为不变。
    --live-dump F  直播档顺手存实拍叠加图（每 5 秒最多一张，验证用；默认不存）
    --live-fast    直播档推帧缩放换 INTER_NEAREST（板上实测 75ms -> 13.5ms/帧，
                   1.25 倍上采样看不出区别）。fps 不够就翻这一档，别的不动。
    --fire-margin M  ★ 兼容保留（2026-10-28 起不限制球位）：**输入层开着 = 发射
                  模式** —— 平时一帧都不预测；手机按"发射"（键盘空格）才发一杆。
                  **球在红色场区内任意位置都可识别/初始/发射**（球身压着场区即可；
                  喂 PL 仍会夹回安全盒）；方向 = **界面绝对角**（0°=右水平、
                  逆时针为正，360° 一圈）、发射点 = 球的位置。
                  ★★ 2026-10-05 规则订正：发射 = **真球入场**——球留场里飞
                  （镜面反射、多球互撞），弹到出射（进洞）为止，轨迹实时上屏
                  （realtime_ball，与瞄准预览逐位一致）。
   --match        ★ M2.2 局状态机（2026-10-06；规则书 v4 / game_pc/main.py 移植，
                  纯逻辑在 match_flow.py，自检 44/44）：10 局制（第 n 局 n 块）、
                  局前(第 2 局起)→局中→结算 2.6s→下一局、平局加赛；弹药每局
                  3 红 2 蓝（按**实物球颜色**扣，未知色不设限）；进球 +10、本局
                  立即结束；30s 洞口计时（暂停冻结；移动逻辑 M2.4 接）。局前就绪
                  = 双方各按自己的发射键（空格/回车）。**默认关**：不带 --match
                  时本脚本行为一个字节都不变；需要 --v3-input（发射模式）。
  一条命令跑（板上）：./game_v3.sh    # = pl_probe 把关 + 上面这些参数的默认值

退出码：0 正常跑完；9 环境问题（抓不到帧/地图不可信）
"""

import atexit
import json
import math
import os
import subprocess
import sys
import threading
import time

sys.path.insert(0, '/boot')
sys.path.insert(0, '/home/xilinx/wp')

import cv2
import numpy as np

# ★ 2026-10-01 深夜（用户三条之③）：发射结果的落点 —— **游戏写、手机读**。
#   serve 的 /shot 端点读的是同一份（v3_input.SHOT_PATH，同一个环境变量）。
_SHOT_PATH = os.environ.get('V3_SHOT_PATH', '/dev/shm/v3_shot.json')
# ★ 2026-10-06（用户："网页应该实时刷新有几个球的序号"）：场上球列表（号+颜色），
#   游戏写、serve 的 /balls 读、手机网页做成**动态选球按钮**。
_BALLS_PATH = os.environ.get('V3_BALLS_PATH', '/dev/shm/v3_balls.json')
# ★ 2026-10-07 M2.3：对局状态文件（手机 /match 读；--match 时每 0.5s 原子写）
_MATCH_PATH = os.environ.get('V3_MATCH_PATH', '/dev/shm/v3_match.json')


def main():
    # ★★ 2026-10-05 深夜（野 DMA 事故实锤后加的保险）：本项目从 ssh 后台任务启动，
    #   **SIGINT 被继承成"忽略"**，现场杀进程只能用 SIGTERM —— 而 TERM 默认"立刻死"，
    #   **不跑 atexit ⇒ 停不了 VDMA ⇒ 野 DMA**（今晚实锤：r13 被 TERM 杀 → r14 一起来
    #   就 segfault、import pynq 都死；用不依赖 PYNQ 的 link_doctor --halt 一停野 DMA，
    #   import 立刻恢复）。把 TERM 接成优雅退出（转 SystemExit），atexit 就能收 DMA。
    import signal as _signal
    try:
        _signal.signal(_signal.SIGTERM, lambda *_a: sys.exit(0))
    except Exception:
        pass
    secs = 60.0
    render_every = 0
    trail_len = 30
    max_r = 120.0                    # ★ 2026-10-23：320→120，拒手的大块团（球实测 19~27 块）
    # ★ P1：V3 实时预测的参数（**默认全关** —— 不带 --v3 时本脚本的行为一个字节都不变）
    v3_every = 0                     # 每 K 个有效帧预测一次（0=关）
    v3_seed, v3_b = 7, 0.40          # 场区：与定妆照同一套（seed=7 -> 3 块磁场 + 左右两洞）
    v3_fan, v3_steps = 12.0, 600     # 扇角半宽 / 积分步数（600 步 ≈ 2.5s，够画出射）
    v3_angle, v3_speed = 0.0, 400.0  # 界面输入值（0°=右水平/逆时针、400 px/s）
    # ★ 2026-10-05 双人：P2 独立的角度/速度（手机网页下半区写的 p2_*）
    v3_angle2, v3_speed2 = 0.0, 400.0
    # ★ 2026-10-05 夜：**选球**（每个玩家控哪颗编号的球；手机网页 [球1/2/3] 可切）
    v3_ball1, v3_ball2 = 1, 2
    # ★★ P2：输入层（手机网页遥控 / 有线键盘）—— 两个源写**同一份状态文件**，这里每帧读。
    #   **默认 None = 完全不开**：不带 --v3-input 时本脚本行为一个字节都不变（铁律）。
    #   特殊值 'auto' = /dev/shm/v3_input.json（v3_input.PATH_DEFAULT）。
    v3_input = None
    v3_hub = None                    # v3_input.InputHub，开了才有
    # ★★ M2.2 局状态机（--match）：默认关（铁律同 --v3-input —— 不带 --match 时
    #   本脚本行为一个字节都不变）。需要输入层（对局靠它读"发射/就绪/选球"）。
    match_on = False
    # ★★ 2026-10-16 粒子引擎（档3，--pe）：**默认关**（铁律同 --v3-input）——
    #   不带 --pe 时本脚本行为一个字节都不变。
    v3_pe = False
    # ★ 2026-10-17 修：'mod' 键原来只在 MATCH=1 时才补（378 行）——**不带 MATCH 跑
    #   沙盒模式时**，_phone_state_tick(_MF['ob'], _MF['mod'], ...) 在 0.5s 节拍处
    #   抛 KeyError: 'mod' **开局即崩**（首现于 r90 风暴试玩；此前所有上板实跑都带
    #   MATCH=1，从没暴露）。初始化就带上 None，函数内 `ob is not None` 门会整段跳过。
    _MF = {'ob': None, 'mod': None, 't': None}  # 局状态机实例 + 计时基准（match_flow.MatchFlow）
    v3_arcs = True                   # 画完整折线（折线由板载 CPU 跑定点黄金模型给，不是 PL）
    v3_dump = 'v3_live.png'
    v3_track_angle = '--v3-track-angle' in sys.argv
    v3_hdmi = '--v3-hdmi' in sys.argv    # ★ P2：HDMI 直出（hdmi_out.FramePump）；默认关
    v3_pump = None                       # 帧泵实例，真开起来才有
    # ★★ 2026-10-01 夜（用户①+③两点）：直播档 / 进球复盘 / 追踪只认场区内
    #   ① `--v3-hdmi-live`：老的 stst 是"每次预测停机换一张图"——屏幕一闪一闪、而且
    #      全程看不到实拍。直播档 = **单缓冲原地写、DMA 全程不停**，每个循环抓一张
    #      原图叠上场区/球/轨迹推上屏：屏幕 = **摄像头实拍 + 跟踪叠加**（不闪不黑）。
    #   ③ `--v3-review S`：这一杆（扇形**正中那一路** = 球员瞄的角度）判定 goal（进洞）
    #      -> 屏幕切到该次的轨迹复盘图 S 秒，然后自动回直播（"进球后的复盘"）。
    #   ② `--track-margin P`：追踪只认**场区外扩 P 游戏像素**内的候选 —— 场外的
    #      手机支架/黑色网线不再靠"面积最大"抢走目标（上一趟 38% 的时间在抢）。
    #   `--live-dump F`：直播档顺手存一张实拍叠加图（每 5s 最多一张，验证用）。
    #   ★ 不给这些旗标时，本脚本行为一个字节都不变（铁律）。
    v3_hdmi_live = '--v3-hdmi-live' in sys.argv
    v3_review = 6.0                      # 复盘图停留秒数（0 = 关掉复盘）
    _review_given = '--v3-review' in sys.argv
    track_margin = 20.0                  # 场区外扩容差（游戏像素）
    # ★ 2026-10-01 深夜（用户三条）：发射模式的门槛 —— 球心离最近那条边 ≤ 这个值
    #   才算"摆在边界上"。70px @ 场区 960x540（实体约 480mm 宽）= 离边 ~35mm。
    fire_margin = 70.0
    live_dump = None                     # 直播档存图路径（None = 不存）
    #   `--live-fast`：推帧缩放换 INTER_NEAREST（板上实测 75ms -> 13.5ms/帧）。
    #   1.25 倍上采样看不出区别；直播档 fps 不够就翻这一档（不改别的任何东西）。
    live_fast = '--live-fast' in sys.argv
    # ★ 2026-10-24：串口屏状态输出（TJC 115200, page index）。
    #   默认关；`--screen`（或 game_v3.sh SCREEN=1）打开。串口没插/掉线不影响游戏。
    screen_on = '--screen' in sys.argv
    # ★ 2026-10-25：HDMI 去 HUD（状态已上串口屏）+ 场区裁剪放大。
    #   `--no-hud` 去掉顶部/底部常驻文字（保留瞬时道具横幅，裁剪后画）；
    #   `--live-crop` 按标定场区 bbox + margin 裁剪再缩放到 1280x720。
    no_hud = '--no-hud' in sys.argv
    live_crop = '--live-crop' in sys.argv
    crop_margin = float(os.environ.get('LIVE_CROP_MARGIN', '0.03'))
    for i, a in enumerate(sys.argv):
        if a == '--sec' and i + 1 < len(sys.argv):
            secs = float(sys.argv[i + 1])
        if a == '--render' and i + 1 < len(sys.argv):
            render_every = int(sys.argv[i + 1])
        if a == '--trail' and i + 1 < len(sys.argv):
            trail_len = int(sys.argv[i + 1])
        if a == '--max-r' and i + 1 < len(sys.argv):
            max_r = float(sys.argv[i + 1])
        if a == '--v3' and i + 1 < len(sys.argv):
            v3_every = int(sys.argv[i + 1])
        if a == '--v3-seed' and i + 1 < len(sys.argv):
            v3_seed = int(sys.argv[i + 1])
        if a == '--v3-b' and i + 1 < len(sys.argv):
            v3_b = float(sys.argv[i + 1])
        if a == '--v3-fan' and i + 1 < len(sys.argv):
            v3_fan = float(sys.argv[i + 1])
        if a == '--v3-steps' and i + 1 < len(sys.argv):
            v3_steps = int(sys.argv[i + 1])
        if a == '--v3-angle' and i + 1 < len(sys.argv):
            v3_angle = float(sys.argv[i + 1])
        if a == '--v3-speed' and i + 1 < len(sys.argv):
            v3_speed = float(sys.argv[i + 1])
        if a == '--v3-dump' and i + 1 < len(sys.argv):
            v3_dump = sys.argv[i + 1]
        if a == '--v3-input' and i + 1 < len(sys.argv):
            v3_input = sys.argv[i + 1]
        if a == '--match':
            match_on = True
        if a == '--pe':
            v3_pe = True
        if a == '--v3-review' and i + 1 < len(sys.argv):
            v3_review = float(sys.argv[i + 1])
        if a == '--track-margin' and i + 1 < len(sys.argv):
            track_margin = float(sys.argv[i + 1])
        if a == '--fire-margin' and i + 1 < len(sys.argv):
            fire_margin = float(sys.argv[i + 1])
        if a == '--live-dump' and i + 1 < len(sys.argv):
            live_dump = sys.argv[i + 1]
    if '--v3-no-arcs' in sys.argv:
        v3_arcs = False
    # ★ 记下**配置值**：循环里连续失败会把 v3_every 清零，汇总时不能拿它当分母
    v3_every_cfg = max(1, v3_every)
    if v3_input is not None and not v3_every:
        # ★ 静默失败最贵：给了 --v3-input 却没开 --v3，输入层是**不会生效**的
        #   （它只喂 V3 预测那一簇）。必须喊出来，不然演示时按半天没人理。
        print('[输入] ★ --v3-input 给了，但 --v3 没开 -> 输入层**不生效**；'
              '加 --v3 6 之类的才有人读它')
        v3_input = None
    if v3_pe and v3_input is None:
        print('[粒子] ★ --pe 给了，但输入层没开（--v3-input）-> 风暴键没有输入源，不生效')
        v3_pe = False
    if match_on and v3_input is None:
        # ★ 静默失败最贵（同族第四例）：对局靠输入层读"发射（=就绪）/选球"，
        #   输入层没开它就没有任何输入源 —— 必须喊出来，不许默默不开。
        print('[对局] ★ --match 给了，但输入层没开（--v3-input）-> 局状态机**不生效**')
        match_on = False
    if v3_hdmi and not v3_every:
        # ★ 同一个坑（静默失败最贵）：HDMI 直出推的是 **V3 每次预测画的那张图**，
        #   没开 --v3 就没人画图 -> 屏幕上只剩帧泵启动时的深灰底，看着像"死机"。
        print('[HDMI] ★ --v3-hdmi 给了，但 --v3 没开 -> HDMI 直出**不生效**；'
              '它推的是 V3 每次预测画的那张图，加 --v3 6 之类的才有人喂它')
        v3_hdmi = False
    if v3_hdmi_live and not v3_hdmi:
        # ★ 静默失败最贵（第 N 次）：直播档只是**帧泵的一个模式**，没有 --v3-hdmi
        #   就没有帧泵，直播档会一声不吭地不生效 —— 现场"屏幕没画面"最难查。
        print('[直播] ★ --v3-hdmi-live 给了，但 --v3-hdmi 没开 -> 直播档**不生效**；'
              '直播档是帧泵的一个模式，两个旗标一起给')
        v3_hdmi_live = False
    if _review_given and not (v3_hdmi and v3_hdmi_live):
        print('[复盘] ★ --v3-review 给了，但没有 --v3-hdmi --v3-hdmi-live -> '
              '复盘**不生效**（它是直播档的伴生件）')

    # ★ 2026-10-24 串口屏：import 失败只关屏、不带走游戏（静默失败最贵）
    _screen_out = None
    if screen_on:
        try:
            import screen_out as _screen_out
            # ★ 2026-10-25：上次进程可能停在加球选择页；开局先切回状态页
            _screen_out.set_page('index')
            print('[屏幕] 串口屏状态输出已开（TJC 115200，页面 index）',
                  flush=True)
        except Exception as _escr:
            print('[屏幕] ★ --screen 给了但 import screen_out 失败：%s'
                  % str(_escr)[:120], flush=True)
            screen_on = False

    if '--bit-only' in sys.argv:
        # 守护脚本用的"只重配 PL"档：下完 bit 就退出（给 game_loop.sh 的第 2 级救援用）
        from pynq import Bitstream
        Bitstream('/boot/ov5640_m1a_wrapper.bit').download()
        print('[加载] 已重配 PL（--bit-only）')
        return 0
    if '--nobit' not in sys.argv:
        from pynq import Bitstream
        Bitstream('/boot/ov5640_m1a_wrapper.bit').download()
        print('[加载] bit 已下载')

    from ball_detect import _make_cap, _init_video
    from fastmem import FastMem
    from ball_map_detect import (MAP_BASE, CTRL_BASE, STAT_BASE, BLK, BH, BW,
                                 read_map, map_to_bgr, map_gate, detect_map,
                                 detect_map_bg, detect_map_from_stats,
                                 _ring_median_fast, raw_to_bgr,
                                 frame_sane_map, load_bg_words, bg_words_to_bgr)
    from vdma_capture import WD_STAT

    # ★ 2026-10-20 差距 1：PL 检测 v1（掩码+形态学+CCL）—— MAPDET_PL=1 时
    #   PL 出候选统计，PS 只做 classify_map 复判（detect_map_from_stats）。
    #   默认关：bit 里没有 map_detect_axi 时开它只会多一条错误日志。
    _plmd = None
    if os.environ.get('MAPDET_PL') == '1' or '--mapdet-pl' in sys.argv:
        try:
            from map_detect_pl import MapDetect, VER_V1
            _plmd = MapDetect()
            _pv = _plmd.read()['version']
            if _pv != VER_V1:
                print('[检测] PL 检测 VERSION=0x%08X（要 v1）-> 关闭 PL 路径' % _pv)
                _plmd.close()
                _plmd = None
            else:
                _plmd.enable()
                print('[检测] PL 路径已开：PL 出候选统计，PS 只复判（classify_map）')
        except Exception as e:
            print('[检测] PL 路径开不了（%s）-> 回退 PS' % str(e)[:80])
            _plmd = None

    # ★ 启动先确认传感器没被"上一轮的救援残留"按在断电状态（bit0/bit1 = pwdn/停 xclk）
    try:
        from pynq import MMIO as _M
        _m = _M(0x43A30000, 0x1000)
        _v = _m.read(0x00)
        if _v & 0x03:
            _m.write(0x00, _v & ~0x03)
            print('[电源] 启动时发现传感器被按住断电（ctrl=0x%08X）-> 已放开' % _v)
            time.sleep(0.8)
    except Exception as e:
        print('[电源] 电源位体检跳过（%s）' % str(e)[:60])
    cap = _make_cap()
    # ★ 场景门禁（2026-09-29 夜）：热身帧均值低于阈值就直接**拒跑**（要硬跑 --allow-dark）。
    #   见 ball_detect._init_video 里那段注释：热身帧均值 91.8 = 镜头对场区、灯亮、球在场；
    #   13.5 = 镜头朝下对着桌面（昨晚白跑两趟的真实原因，当时还被我误判成"光照/曝光"）。
    _init_video(cap, dark_gate=True)
    swap = 1 if getattr(cap, '_swap_decided', False) else 0
    print('[配置] 原图 swap=%d  max_r=%.0fpx  跑 %.0fs' % (swap, max_r, secs))

    # ★★ 背景必须**懒解码**（2026-09-29 凌晨实锤的 bug）：
    #   文件里存的是**原始地图字**（uint16 扁平，11520 个），**不是 BGR 图**。
    #   原来这里是 `bg_map = np.load(BG_MAP)` 直接当图喂给 detect_map_bg
    #   -> `cv2.absdiff((90,128,3), (11520,))` **尺寸不匹配** -> 抛异常
    #   -> 整个 60 秒长跑**当场崩掉**（0 帧 + traceback，今晚白跑一趟）。
    #   正确姿势（v3_scan.py 相机路径一直是这么写的，这里没跟上）：
    #   先 load_bg_words 拿原始字，等**字节序判定 mswap 定下来**再 bg_words_to_bgr
    #   解码 —— 背景存原始字就是为了跟"当时判的字节序"解耦。
    bg_words = None
    bg_map = None
    if '--no-bg' not in sys.argv:
        bg_words = load_bg_words()
        if bg_words is not None:
            print('[背景] 已载入差分背景（%d 个原始字）-> 等字节序定下来再解码'
                  % bg_words.size)
        else:
            print('[背景] 没背景图/格式不对 -> 单帧颜色掩码（先 --bgcap 拍一张更好）')
    else:
        print('[背景] --no-bg：单帧颜色掩码')

    map_max_area = int(np.pi * (max_r / float(BLK)) ** 2 * 1.2)

    # 游戏状态：球在哪、往哪走、轨迹
    trail = []
    n_frames = n_hit = 0
    _FT = []                      # ★ 2026-10-28：最近 30 帧时间戳（算**即时**帧率）
    t_start = time.time()
    t_det = []
    last_render = 0
    outdir = '/home/xilinx/wp' if os.path.isdir('/home/xilinx/wp') else '/boot'

    # ---- ★ P1：V3 实时预测的场区与标定（不带 --v3 就整段跳过，什么都不碰）----
    v3_world = v3_V = v3_H = v3_mod = None
    live_balls = []                              # ★ 真球队列（2026-10-05 规则订正）
    _tracks = []                                 # ★ 2026-10-25：局前也要用（/match 刷新）
    import ball_tracker as _btk                  # ★ 多目标追踪（2026-10-05 用户需求）
    trk = _btk.MultiTracker()
    if v3_every:
        import v3_scan as _vs
        import v3_fixedpoint as _vf
        import realtime_ball as _rtb              # ★ 真球实时模拟（与预览逐位一致）
        import phys_objects as _po                # ★ 实物识别（黑条/绿椭圆/黑球）
        v3_mod, v3_V = _vs, _vf
        v3_world = _norm_holes(
            _vs.build_world(v3_seed, v3_b))    # 与出图脚本同一份 build_world
        v3_world.obstacles = _OBST                    # ★ 布置 PLACE：已摆障碍跨世界回注
        # ★★ 2026-10-04 用户定案（演示模式，"预设轨迹看着能打到就是要打到"）：**两个绿洞都算进**。
        #   洞的 target 原本是两人对战里的语义（对面选手的靶：左=1/右=0），而单人演示 side
        #   恒 0 ⇒ 左洞会被当成**一面墙**（撞上就弹回去，屏幕上完全看不出来）——但左边那个
        #   洞和右边画得一样绿，玩家必然读成"这条线进了"。做法：建完场景把每个洞的 target
        #   都摊成 0（side=0 ⇒ 全部匹配）。**不动 RTL**：v3_pl.write_scene 是先在软件里算好
        #   (target==side) 一位、再写进洞表寄存器的（v3_pl.py 第 80 行），改的是数据不是逻辑。
        for _h in v3_world.holes:
            _h['target'] = 0
        # ★★ 2026-10-16 粒子引擎（档3，--pe）：打开 PL 里的 pe_axi（0x40001000）。
        #   失败不致命（旧 bit 没映射这块——显式 --pe 才走到这，默认路一字不变）。
        if v3_pe:
            try:
                import particle_pl as _ppl
                _PEB['mm'] = _ppl.open_pe()
                _PEB['mod'] = _ppl
                _PEB['on'] = True
                _PEB['scene_key'] = None
                print('[粒子] ★ PL 粒子引擎已打开（BASE=0x40001000；16 粒并行物理；'
                      'B/N 放风暴）')
            except Exception as _epe:
                _PEB['on'] = False
                print('[粒子] ★ 打开失败（%s）—— bit 不是带 pe_axi 的新版？--pe 失效，'
                      '游戏照跑' % str(_epe)[:140])
        v3_H = _vs.load_calib(verbose=True)           # 相机像素 -> 游戏坐标
        print('[V3] 实时预测开启：每 %d 个有效帧一次  seed=%d B=%s  扇±%.0f° %d 步  折线=%s'
              % (v3_every, v3_seed, v3_b, v3_fan, v3_steps,
                 'all(17 路)' if v3_arcs else 'crit(仅临界那条)'))
        print('[V3] 场区：块=%d  洞=%s' % (len(v3_world.blocks),
              [(h['edge'], round(h['c']), h['target']) for h in v3_world.holes]))
        print('[V3] 入射角/速度 = %s'
              % ('**跟踪值**' if (v3_track_angle or v3_speed <= 0) else
                 '按键输入 %.1f°（0=右/逆时针）/ %.0f px/s'
                 '（规则默认；球是摆的不是推的）'
                 % (v3_angle, v3_speed)))
        if v3_H is None:
            print('[V3] ★ 没有标定 -> 球位按"画幅≙场区"折算，近景下会偏；'
                  '先跑 v3_calib.py --shot 更准')
        # ★ 2026-10-01 夜（用户第②点）：追踪只认场区内的球 —— 这里把口径喊出来
        #   （球要放"边界上"，所以容差不是 0；场外的手机支架/网线从此一票否决）
        print('[跟踪] 只认场区内的球：候选球心须落在场区外扩 %.0f 游戏像素内'
              '（--track-margin 可调；场外的大块不再抢目标）' % track_margin)
        if v3_H is None:
            # ★ 实话实说：没有标定时，"画幅≙场区"会把**整个相机画面**都算进场区框里
            #   （s_m=0.75 时相机 1024x720 覆盖游戏 1365x960）—— 场外的大块照样抢目标。
            print('[跟踪] ★ 但没有标定：默认假设下整个画面都落在场区框里 -> 拦不住场外大块；'
                  '要真拦住先跑 v3_calib.py --shot 生成 v3_calib.json')

        # ---- ★★ P2：输入层（手机网页 `v3_input.py serve` / 有线键盘 `v3_input.py key`）----
        #   两个源写**同一份状态文件**，这里每帧 poll 一次（内容没变就 54µs，板上实测）。
        #   ★★ 2026-10-01 深夜（用户①②③三条）：**输入层开着 = 发射模式** ——
        #     平时一帧都不预测（下面的周期预测块被 `v3_hub is None` 挡掉），
        #     手机"发射"/键盘空格写 fire 计数，游戏读它的**上升沿**在循环里发一杆
        #     （见"发射模式"块）。玩法规则见 --fire-margin 的用法注释。
        if v3_input is not None:
            # ★ 2026-10-06（选球写回 bug 的根因）：这里原来只 import 了 InputHub ——
            #   模块名没绑，而局部变量 `v3_input` 存的是**参数串**（如 'auto'）；
            #   选球块里 `v3_input.write_state(...)` 于是撞名 AttributeError 被吞。
            #   现在把 write_state 也显式引进来（选球写回用它，且必须带 path=_p）。
            from v3_input import (InputHub, PATH_DEFAULT as _V3IN_PATH,
                                  write_state as _v3in_write)
            _p = _V3IN_PATH if v3_input in ('auto', '') else v3_input
            # ★★ 2026-10-06（"选球永远锁在1号"的根因·之一）：主循环的**直播存图**
            #   块会复用 `_p` 这个名字（`_p = live_dump…`，每 ~5s 一次）——选球
            #   写回若用 `_p` 当路径，就会被写成 /dev/shm/live.bmp（还合法不报错！）。
            #   专名保存，选球写回一律用 _v3in_path。
            _v3in_path = _p

            # ★★ M2.2 局状态机（--match）：装在输入层罩子里 —— 对局靠输入层读
            #   "发射（=就绪）/选球"，没有输入层它没有任何输入源（上面已拦并喊）。
            if match_on:
                import match_flow as _mflow
                import hole_adapt as _ha      # ★ M2.4 洞口自适应（30s 无进球触发）
                _MF['ob'] = _mflow.MatchFlow()
                _MF['mod'] = _mflow           # 常量来源（_match_snapshot 用；不许再 import）
                print('[对局] ★ 局状态机开（10 局制）：%s'
                      % _MF['ob'].status_line(), flush=True)
                # ★ 2026-10-25 测试种子（**默认关**，正式运行不要设）：
                #   TEST_GIVE_BALLS=2 -> 双方各 2 个加球道具，跳过"打一局攒分买"。
                #   只影响 items['ball']，不碰积分/其它道具。变量名用 _tp，别覆盖
                #   上面的 `_p`（那是输入状态文件路径，后面 InputHub 还要用）。
                try:
                    _tgb = int(os.environ.get('TEST_GIVE_BALLS', '0') or 0)
                except Exception:
                    _tgb = 0
                if _tgb > 0:
                    for _tp in (1, 2):
                        _MF['ob'].items[_tp]['ball'] = max(
                            int(_MF['ob'].items[_tp]['ball']), _tgb)
                    print('[测试] ★ TEST_GIVE_BALLS=%d：双方加球道具各 %d'
                          '（仅测试；正式运行不设这个环境变量）'
                          % (_tgb, _tgb), flush=True)
                # ★ 2026-10-27 测试种子：TEST_GIVE_POINTS=50 -> 双方积分；
                #   只给货币，**商店购买仍然是真买**（买障碍/传送门/加球）。
                try:
                    _tgp = int(os.environ.get('TEST_GIVE_POINTS', '0') or 0)
                except Exception:
                    _tgp = 0
                if _tgp > 0:
                    for _tp in (1, 2):
                        _MF['ob'].points[_tp] = max(
                            int(_MF['ob'].points[_tp]), _tgp)
                    print('[测试] ★ TEST_GIVE_POINTS=%d：双方积分各 %d'
                          '（仅测试；商店购买仍是真买）' % (_tgp, _tgp),
                          flush=True)
                # ★★ 2026-10-29 用户点单：**专用「购买→摆放→识别」测试局**。
                #   TEST_START_PREP=1：强制第 1 局停在 PREP（商店解锁）并把商店
                #   画面直接打开；配合 TEST_GIVE_POINTS 走完整道具流程。
                #   正式运行不设这个环境变量（默认关）。
                try:
                    _tsp = int(os.environ.get('TEST_START_PREP', '0') or 0)
                except Exception:
                    _tsp = 0
                if _tsp > 0:
                    _MF['ob'].phase = 'PREP'
                    _MF['ob'].sub = {1: 'SHOP', 2: 'SHOP'}
                    _MF['ob'].phys_bought = {1: False, 2: False}
                    _MF['ob'].phys_placed = {1: False, 2: False}
                    _MF['ob'].adjust = False
                    _MF['ob'].msg, _MF['ob'].msg_t = (
                        '测试模式：局前商店已解锁（买实体件→立即摆放）', 999.0)
                    _SHOPV['open'] = True
                    # ★★ 2026-10-29 测试局实锤（"买完按使用没反应"）：
                    #   `base_ready` 只在 PLAY 的检测路径里建立；强制 PREP 时
                    #   它永远 False -> `_pplace_enter` 一直回「相机还在稳定中」。
                    #   测试局直接置位（免费基线为空——所有条都算新件，正好测摆放）。
                    _PHYS['t0'] = time.time()
                    _PHYS['base_ready'] = True
                    _PHYS['base_bars'] = []
                    _PHYS['base_greens'] = []
                    print('[测试] ★ TEST_START_PREP=1：第 1 局强制停在 PREP、'
                          '商店画面已打开、识别基线置位（仅测试；购买仍是真买）',
                          flush=True)
                # ★★ 2026-11-01 用户演示用：一次性「残局种子」（默认关）。
                #   DEMO_START_R7=1：开局直接第 7 局、局分/积分 100:100、
                #   P1 红2（无蓝）/ P2 蓝2（无红）；第 8 局起走正常流程。
                try:
                    _r7 = int(os.environ.get('DEMO_START_R7', '0') or 0)
                except Exception:
                    _r7 = 0
                if _r7 > 0:
                    _m = _MF['ob']
                    _m.round = 7
                    _m.goals = {1: 10, 2: 10}        # 局分 = goals×10 = 100:100
                    _m.points = {1: 100, 2: 100}     # 积分 100:100
                    _m.ammo = {1: {1: 2, -1: 0},     # P1 两红
                               2: {1: 0, -1: 2}}     # P2 两蓝
                    _m.timer = 0.0
                    _m.grace = None
                    _m.round_goals = {1: 0, 2: 0}
                    _m.free_hole = {1: 1, 2: 1}
                    _m.items = {p: {k: 0 for k in _mflow.ITEM_KEYS}
                                for p in (1, 2)}
                    _m.phase = 'PLAY'
                    _m.sub = {1: 'READY', 2: 'READY'}
                    _m.phys_bought = {1: False, 2: False}
                    _m.phys_placed = {1: False, 2: False}
                    _m.adjust = False
                    # 清掉构造时留下的"第 1 局开始"提示（手机页会显示 msg），
                    # 避免残局第 7 局开头闪一下第 1 局文案。
                    _m.msg, _m.msg_t = '', 0.0
                    # ★ 关键：MatchFlow() 构造时排了一个 round_start(1) 事件；
                    #   不丢掉的话第一帧会把场界按"第 1 局"（1 块）重建，覆盖残局。
                    try:
                        _m.drain()
                    except Exception:
                        pass
                    # 第 7 局 = 7 块磁场（规则书 §1）；洞口沿用默认（残局不随机）。
                    v3_world = _norm_holes(_vs.build_world(v3_seed, v3_b,
                                                          n_blocks=7))
                    v3_world.obstacles = _OBST
                    for _h in v3_world.holes:
                        _h['target'] = 0
                    print('[演示] ★ DEMO_START_R7=1：残局第 7 局（场界 %d 块），'
                          '局分/积分 100:100，P1 红2 / P2 蓝2（第 8 局起正常）'
                          % len(v3_world.blocks), flush=True)
            # ★ 发射方向 = 边法线 + 输入角 —— 角度/速度**必须由输入层给**。
            #   --v3-track-angle / --v3-speed 0 会把它们改走**跟踪值**（球是静止摆着的，
            #   跟踪速度≈0）—— 那是"按了没反应"一类最难查的故障，这里**强制纠正**并喊出来。
            if v3_track_angle or v3_speed <= 0:
                print('[发射] ★ --v3-track-angle / --v3-speed 0 与发射模式冲突：'
                      '方向必须是"边界法线 + 输入角" -> 强制纠正（track_angle=False、'
                      'speed=%s）' % ('%.0f' % v3_speed if v3_speed > 0 else '400'))
                v3_track_angle = False
                if v3_speed <= 0:
                    v3_speed = 400.0
            v3_hub = InputHub(path=_p, angle=v3_angle, speed=v3_speed)
            _a, _s, _ch = v3_hub.poll()      # 开局先吃一笔：手机可能起游戏**之前**就设好了
            if _ch:
                print('[输入] 开局就吃到一笔（%s 写的）：%.1f° / %.0f px/s'
                      ' —— 盖掉命令行给的 %.1f° / %.0f'
                      % (v3_hub.src, _a, _s, v3_angle, v3_speed))
            v3_angle, v3_speed = _a, _s
            # ★ 发射计数只认**上升沿**：开局把基准对齐到文件里的现值（上一趟残留的
            #   fire=3 也不许被当成"刚点了发射"）。
            # ★ 2026-10-05 双人：开局把**两个玩家**的发射计数都对齐到当前值——
            #   否则文件里的旧计数会被当成"上升沿"，一开局自发一杆
            #   （实锤：r20 开局 P1 自动打了一杆）。last1/last2 = 各自玩家的基准。
            _FIRE['last1'] = v3_hub.fire
            _FIRE['last2'] = v3_hub.fire2
            # ★★ 2026-10-15（板 r76 实锤"幽灵重放"）：同一条纪律要铺到**所有**
            #   计数器——状态文件跨局存活，重启后第一帧会把上一局的按键当**新事件**
            #   （实况：r76 开局自己冒出一个"加洞口→被旧 ESC 取消→旧点位置被忽略"）。
            #   这里把 _MAS / _SEL / _SHOP 的每个键**逐键**对齐到 hub 现值：
            #   只有之后**新发生**的笔才算数（宁可不做，也不做一记莫名其妙的）。
            #   ⚠ 别名：确认计数在 _MAS 里叫 cfmN、在 hub 里叫 buyN——别抄错。
            for _bk, _bv in (('edit1', v3_hub.edit1), ('edit2', v3_hub.edit2),
                             ('hole1', v3_hub.hole1), ('hole2', v3_hub.hole2),
                             ('mup1', v3_hub.mup1), ('mdn1', v3_hub.mdn1),
                             ('mup2', v3_hub.mup2), ('mdn2', v3_hub.mdn2),
                             ('aup1', v3_hub.aup1), ('adn1', v3_hub.adn1),
                             ('aup2', v3_hub.aup2), ('adn2', v3_hub.adn2),
                             ('esc', v3_hub.esc),
                             ('cfm1', v3_hub.buy1), ('cfm2', v3_hub.buy2),
                             ('hopos1', v3_hub.hopos1),
                             ('hopos2', v3_hub.hopos2),
                             # ★ 2026-10-19：风暴计数也要对齐（此前漏了——重启后
                             #   旧计数要么幽灵触发、要么新笔被当旧账）
                             ('pe1', v3_hub.pe1), ('pe2', v3_hub.pe2)):
                _MAS[_bk] = int(_bv or 0)
            for _bk, _bv in (('sup1', v3_hub.sup1), ('sdn1', v3_hub.sdn1),
                             ('sup2', v3_hub.sup2), ('sdn2', v3_hub.sdn2)):
                _SEL[_bk] = int(_bv or 0)
            for _bk, _bv in (('mup1', v3_hub.mup1), ('mdn1', v3_hub.mdn1),
                             ('buy1', v3_hub.buy1), ('mup2', v3_hub.mup2),
                             ('mdn2', v3_hub.mdn2), ('buy2', v3_hub.buy2),
                             ('mbtn', v3_hub.mbtn),
                             ('sopen1', v3_hub.sopen1),
                             ('sopen2', v3_hub.sopen2)):
                _SHOP[_bk] = int(_bv or 0)
            print('[输入] 输入层**开**：%s（手机 serve / 键盘 key 都写这里）' % _p)
            print('[发射] ★★ **发射模式**（输入层开着就是它）—— 用户三条：')
            print('       ① 球摆在**场区边界**上，按"发射"后整条轨迹全是**模拟**'
                  '（PL 判 17 路 + 轨迹图），球不用真的滚；')
            print('       ② 球放在红色场区内**任意位置**都可识别/发射'
                  '（2026-10-28 起取消边界带）；')
            print('       ③ 发射入口：手机网页的大按钮 / 键盘**空格**'
                  '（W/S 调角 ±2°、A/D 调速 ±20、R 复位）。')
            print('       场内任意位置可发：球身压着场区即可（喂 PL 仍会夹回安全盒，'
                  '离边 ≥%.0fpx）；方向=最近边法线+输入角；平时**一帧都不预测**，'
                  '只有按了发射才花那一笔'
                  % (v3_mod.IN_FIELD_MARGIN + v3_mod.BALL_R))
            print('[发射] 结果落在 %s（手机网页 /shot 轮询显示）' % _SHOT_PATH)

        # ---- ★★ P2：HDMI 直出（帧泵 = hdmi_out.FramePump）----
        #   每次预测出图后，把那张图换到板载 HDMI 上（720p60）。换帧走 stst 档
        #   （停机-改地址-重启，与 hdmi_out 自己演示的那条路同一条）。**绝不让屏幕
        #   拖死游戏**：这里启动失败就关掉自己，循环里推帧连败 3 次也关掉自己。
        #   ★ 2026-10-01 夜：`--v3-hdmi-live` 走 live 档（单缓冲原地写，DMA 不停）
        #     —— 上屏的是**实拍+叠加**（每个循环抓一张原图），不是每次预测那张图；
        #     进球复盘图则借同一个泵原地写上去（见循环里的 _REV 状态机）。
        if v3_hdmi:
            try:
                from hdmi_out import FramePump
                v3_pump = FramePump(verbose=False,
                                    interp='nearest' if live_fast else 'linear')
                # ★ 2026-10-23 差距2 第二刀：live2 双缓冲（整帧写后台缓冲 +
                #   Park 指针帧边界换页）。**已上板验收：快晃不闪**，设为默认；
                #   出问题时 `HDMI_DBUF=0` 回退旧的单缓冲 live 档。
                _hdmi_mode = ('stst' if not v3_hdmi_live
                              else ('live' if os.environ.get('HDMI_DBUF', '1') == '0'
                                    else 'live2'))
                # ★★ 2026-10-31：PL 帧泵直接写显存地址 -> 必须**单缓冲**
                _plp_want = os.environ.get('PLPUMP', '0') not in (
                    '0', '', 'false', 'False')
                if _plp_want and v3_hdmi_live:
                    _hdmi_mode = 'live'
                v3_pump.start(mode=_hdmi_mode)
                if _plp_want:
                    try:
                        _plp_init(v3_pump)
                    except Exception as _epi:
                        print('[PL帧泵] 初始化异常（回退 PS）：%s'
                              % str(_epi)[:120], flush=True)
                # ★★ 2026-10-31：SMOOTH=1 -> 球的高频插值叠加（默认关）
                if os.environ.get('SMOOTH', '0') not in ('0', '', 'false', 'False'):
                    try:
                        _sm_start(v3_pump)
                    except Exception as _esm:
                        print('[平滑] 启动失败（不影响游戏）：%s'
                              % str(_esm)[:120], flush=True)
                if v3_hdmi_live:
                    print('[HDMI] 直播档**开**：屏幕=摄像头实拍+场区/球/轨迹叠加，'
                          '%s；缩放=%s'
                          % ('**live2 双缓冲（Park 帧边界换页）**'
                             if _hdmi_mode == 'live2'
                             else '单缓冲原地写、DMA 全程不停（不闪不黑）',
                             'INTER_NEAREST（--live-fast）' if live_fast
                             else 'INTER_LINEAR'))
                    print('       进球复盘：正中那一路判 goal（进洞）-> '
                          '切轨迹复盘图 %.0fs 再回直播%s'
                          % (v3_review, '（--v3-review 0 = 关掉复盘）'
                             if v3_review <= 0 else ''))
                    print('       ★ 提速（2026-10-01 夜）：每 K 帧那次预测平时只读 PL'
                          '判定（轻 tick，~3ms）；折线+渲染那 ~0.6s 只在**真进球'
                          '那一刻**现算一次复盘图')
                else:
                    print('[HDMI] 直出**开**：每次预测的那张图推到 720p60（stst）（%s）'
                          % ('本趟还在写盘 DUMP=%s —— 上屏不需要它，现场档建议'
                             ' --v3-dump none' % v3_dump
                             if (v3_dump and v3_dump.lower() not in ('none', '-'))
                             else '本趟不写盘（--v3-dump none），纯上屏'))
            except Exception as e:
                print('[HDMI] ★ 帧泵启动失败：%s' % str(e)[:160])
                print('       -> HDMI 直出关掉，游戏照跑（屏幕是加分项，不是主线）')
                v3_hdmi, v3_pump = False, None

    with FastMem(MAP_BASE, 0x8000) as mm, \
         FastMem(CTRL_BASE, 0x1000) as mc, \
         FastMem(STAT_BASE, 0x1000) as ms:
        # soft_rst：清 sticky + 让 map 用新帧重建
        mc.wr_u32(0x00, (swap << 2) | 0x02)
        time.sleep(0.2)
        mc.wr_u32(0x00, (swap << 2))
        time.sleep(0.5)

        mswap = None
        fc_prev = t_prev = None
        n_bad = 0
        fc_fresh = None
        t_fresh = time.time()
        t_gate = 0.0
        from pynq import MMIO
        mm3 = MMIO(0x43A30000, 0x10000)
        st = ms.rd_u32(0x00)
        print('[账本] 行数=%d 字数=%d' % ((st >> 16) & 0xFFFF, st & 0xFFFF))

        # ★★ 2026-10-29 改磁场：退出时把进入前的角度/速度写回去
        #   （P1 的 W/S、P2 的 ↑/↓ 在 EDIT 里是"定方向"，不能把对局瞄准参数改了）
        def _edit_do_confirm(m, world, pk):
            _bvx = _edit_apply_value(m, world)
            _ixx = int(m.edit['idx']) + 1
            m.end_edit(confirm=True)
            _MAS['snap'] = None
            _edit_restore()
            print('[道具] P%d 改磁场完成：块 %d B=%+.2f'
                  % (pk, _ixx, _bvx or 0.0), flush=True)
            _item_msg_set('块 %d 磁场已改为 %+.2f' % (_ixx, _bvx or 0.0))
            try:
                _shot_write(dict(t=round(time.time(), 3), ok=True,
                                 why='item', kind='item', seq=0,
                                 msg='P%d 改磁场(块%d B=%+.2f)'
                                     % (pk, _ixx, _bvx or 0.0)),
                            player=pk)
            except Exception:
                pass
            return _bvx

        def _edit_do_stage_confirm(m, world, pk):
            """★ 2026-10-29 用户定案：三步都要确认——选块 -> 方向 -> 数值。"""
            _r = m.edit_confirm_stage()
            _ix = int(m.edit['idx']) + 1
            if _r == 'DIR':
                try:
                    _b2 = float(world.blocks[int(m.edit['idx'])].b)
                except Exception:
                    _b2 = 0.0
                print('[道具] P%d 确认选块 %d（B=%+.2f）——W/S（P2 ↑/↓）定方向，'
                      '方向需再确认' % (pk, _ix, _b2), flush=True)
                _item_msg_set('已选块 %d——W/S（P2 ↑/↓）定方向，再按 %s 确认方向'
                              % (_ix, 'E' if int(pk) == 1 else '小键盘 *'))
            elif _r == 'VALUE':
                _sg = '+' if int(m.edit.get('sign', 1)) >= 0 else '-'
                print('[道具] P%d 确认方向 %s（块 %d）——输入数值，再确认修改'
                      % (pk, _sg, _ix), flush=True)
                _item_msg_set('方向 %s——输入大小（0.10~0.80），再按 %s 确认修改'
                              % (_sg, 'E' if int(pk) == 1 else '小键盘 *'))
            elif _r == 'CONFIRM':
                _edit_do_confirm(m, world, pk)
            return _r

        def _edit_do_back(m):
            """ESC 退一步：VALUE -> DIR -> SELECT；SELECT 再 ESC = 取消。"""
            _st = m.edit_back()
            if _st == 'DIR':
                _item_msg_set('回到方向——W/S（P2 ↑/↓）重定，确认后再输数值')
                print('[道具] ESC 回到方向阶段', flush=True)
            elif _st == 'SELECT':
                _item_msg_set('回到选块——A/D（P2 ←/→）或鼠标，再确认（ESC=取消）')
                print('[道具] ESC 回到选块阶段', flush=True)
            else:
                _edit_do_cancel(m)
            return _st

        def _edit_do_cancel(m):
            for _b2, _v2 in (_MAS.get('snap') or []):
                _b2.b = _v2
            m.end_edit(confirm=False)
            _MAS['snap'] = None
            _edit_restore()
            print('[道具] %s' % m.msg, flush=True)

        def _edit_restore():
            nonlocal v3_angle, v3_speed, v3_angle2, v3_speed2
            try:
                _a0 = _EDC.get('ang')
                if not _a0:
                    return
                v3_angle, v3_speed, v3_angle2, v3_speed2 = _a0
                _EDC['ang'] = None
                if _v3in_path:
                    _v3in_write(player=1, angle=_a0[0], speed=_a0[1],
                                src='game', path=_v3in_path)
                    _v3in_write(player=2, angle=_a0[2], speed=_a0[3],
                                src='game', path=_v3in_path)
            except Exception:
                pass

        # ★★ 游戏循环**不抓原图**（2026-09-27 改，重要）★★
        #   游戏只要 map（23KB），原图那一帧 1.47MB 抓回来根本没用途 —— 而抓它
        #   每帧要 11~14ms（占循环周期 34ms 的三分之一）。VDMA 是**自循环**的
        #   （circular 模式，num_bufs 个缓冲自己轮转），我们不取数它也照样消费，
        #   流水线照跑、map 照新鲜 ✓。于是循环周期从 34ms 压到 ~23ms。
        #   顺带把"野 DMA / CMA 页被覆盖"这一整类风险从游戏路径上摘掉了。
        n_iter = 0
        # ★★ 2026-10-29（测试局实锤）：`ball` 原来只在"这一帧有检测"的分支里
        #   赋值。强制开局停在 PREP 时第 1 帧检测块不跑 -> 后面的 HUD/画圈
        #   直接引用就 UnboundLocalError（屏幕黑）。循环外先给个 None。
        ball = None
        while time.time() - t_start < secs:
            n_iter += 1
            # ★★ P2：每帧读一次输入层。**放在 t0 之前** —— 否则这点开销会混进
            #   "读回 map"的计时口径里（那笔账好不容易才量干净，不能再脏）。
            #   代价 = 读一个 150 字节的文件 + 比字节（板上实测 54µs，30fps 下 0.16%）；
            #   ★ 比的是**内容**不是 mtime —— 时间戳在 NTFS/FAT 上会骗人（漏写，实测过）。
            if v3_hub is not None:
                _a, _s, _ch = v3_hub.poll()
                if _ch:
                    v3_angle, v3_speed = _a, _s
                    print('[输入] %s 改：%.1f° / %.0f px/s'
                          % (v3_hub.src, _a, _s), flush=True)
                # ★ 2026-10-05 双人：P2 每帧同步（便宜），变了自己吱一声
                v3_angle2, v3_speed2 = v3_hub.angle2, v3_hub.speed2
                v3_ball1, v3_ball2 = v3_hub.ball1, v3_hub.ball2
                # ★★ 2026-10-07 修（启动阶段日志刷屏 1.5 万行实锤）：`changed2` 只在
                #   **文件内容变化的那一次 parse** 里被重算；内容没变的快路径直接
                #   return（干净利落），**不会把它清 False** —— 于是"上一次 P2 改过"
                #   之后，这一行会**每帧**重复打（坏帧空转期更是一秒几百行）。
                #   口径修正：只在"文件真的变了"这一拍（_ch=True）才看 changed2。
                if _ch and v3_hub.changed2:
                    print('[输入] P2 改：%.1f° / %.0f px/s'
                          % (v3_angle2, v3_speed2), flush=True)
            # ★ 2026-10-24 串口屏：5Hz 级节流在 screen_out 内部；只发变化字段。
            #   串口异常由 screen_out 自己吞掉并重试，绝不影响主循环。
            # ★ 2026-10-25 加球选择页：页面开着时暂停状态刷新（给触摸事件让路），
            #   每帧 poll 触摸命令；选完扣道具、取消/超时/离开对局不扣。
            if screen_on and _screen_out is not None:
                _tsc0 = time.perf_counter()
                if not _ABALL['on']:
                    _screen_out.update(_MF['ob'], v3_angle, v3_speed, v3_ball1,
                                       v3_angle2, v3_speed2, v3_ball2)
                _evab = _screen_out.poll_event()
                if _evab is not None:
                    if _ABALL['on'] and _evab in ('red', 'blue'):
                        _whoab = int(_ABALL['who'])
                        _oka, _msga = _aball_finish(_MF['ob'], _evab,
                                                    _screen_out)
                        print('[道具] %s' % _msga, flush=True)
                        _item_msg_set(_msga)
                        if _oka:
                            _shot_write(dict(t=round(time.time(), 3),
                                             ok=True, why='item',
                                             kind='item', seq=0, msg=_msga),
                                        player=_whoab)
                    elif _ABALL['on'] and _evab == 'cancel':
                        _msga = _aball_cancel(_screen_out)
                        print('[道具] %s' % _msga, flush=True)
                        _item_msg_set(_msga)
                    # 非选择态收到的事件直接丢弃（防旧触摸串到下一局）
                if _ABALL['on']:
                    _mab = _MF['ob']
                    if (time.time() - float(_ABALL['t']) > ABALL_TIMEOUT
                            or _mab is None or _mab.phase != 'PLAY'
                            or _mab.grace is not None):
                        _msga = _aball_cancel(
                            _screen_out, '加球选择超时/对局已结束（未扣）')
                        print('[道具] %s' % _msga, flush=True)
                        _item_msg_set(_msga)
                    else:
                        # ★ 切页后再补写 t8 + 三个数字；之后数字变了才重发
                        _aball_set_who(_screen_out)
                        _aball_set_count(_mab, _screen_out)
                _ms_add('screen', _tsc0)
            t0 = time.perf_counter()
            buf, ntry, fc = read_map(mm, mc)
            t1 = time.perf_counter()

            # 帧可信度：速率 + 地图字节序自检（第一次定下来之后不再重判）
            bad = False
            if fc_prev is not None and t_prev is not None:
                fps_now = (fc - fc_prev) / max(1e-3, t1 - t_prev)
                if fps_now < 20.0:
                    bad = True
            fc_prev, t_prev = fc, t1
            if (ms.rd_u32(0x00) & 0xFFFF) != 5760:
                bad = True
            if mswap is None and time.time() - t_gate > 0.5:
                # ★ 自检没过就**再抓一帧重试**（限频 0.5s）。第一版只抓一次启动帧，
                #   那一帧要是撕裂的就永远定不下字序 -> 之后每帧都被拒 -> "0 有效帧"
                #   （实测白跑 70 秒）。抓图只在"自检还没过"期间发生，过了就彻底停手
                #   —— 优化（不抓原图）与可靠性两全。
                t_gate = time.time()
                try:
                    rawg, _ig = _grab(cap)
                except Exception:
                    rawg = None
                if rawg is not None:
                    bs, p0, p1 = map_gate(rawg, buf)
                    if bs is not None and max(p0, p1) >= 60.0:
                        mswap = bs
                        print('[地图] 自检 swap=0 %.1f%% / swap=1 %.1f%% -> 用 %d'
                              % (p0, p1, mswap), flush=True)
            if fc != fc_fresh:
                fc_fresh = fc
                t_fresh = time.time()
            # ★ 主循环自己救链路（不能只靠看门狗线程）：卡住的 AXI 读会把看门狗
            #   线程本身阻塞住（实测"停在 1603，约 29.3s" = 它被卡了 29 秒才动手）。
            #   ★★ 但触发必须**按时间**、并且**限频**（第一版按迭代次数判，而这个
            #   循环空转一次只要 1ms → 8 次 = 8ms → 120 秒里把传感器断电重上电按了
            #   **35 次**，它根本没机会稳定 —— 自己把链路按死了）。
            #   ★★ 2026-10-01 现场教训（fire_run5）：1.2s/5s 太灵敏 —— 慢性退化
            #   链路上帧计数每隔 ~10s 就抽一下（1~3s 自恢复），旧阈值每次都按、
            #   按了又不解决问题，11 次断电重上电把屏幕冻成"一卡一卡"。
            #   现在：≥2.5s 没有新的帧计数才算"真卡"（自恢复的抽风放它过去）；
            #   两次救援之间至少隔 12s（让上一次救援真正落定，别连环按）。
            #   判据抽在 `_rescue_due`（台架 rescue_ladder 场景拿时间线钉死）。
            if _rescue_due(time.time(), t_fresh, _RESCUE):
                # ★ 护栏：救援自己抛异常不许把游戏循环带走（照抄看门狗线程的
                #   纪律"吞可以，但必须留话"）。KeyboardInterrupt 不在 Exception
                #   里，Ctrl-C 照常退出 —— 函数里的 finally 负责还原静止位。
                try:
                    _rescue_escalate(mm3)
                except Exception as _er:
                    print('[自愈] ★ 主循环救援抛异常（这一次没救成）：%s'
                          % str(_er)[:140], flush=True)
            if mswap is None or bad:
                continue

            # ★ 背景懒解码：字节序定下来了才解（见上面 load_bg_words 的注释）
            if bg_words is not None and bg_map is None:
                bg_map = bg_words_to_bgr(bg_words, swap ^ mswap)
                print('[背景] 已按当前字节序解码（swap=%d mswap=%d）' % (swap, mswap),
                      flush=True)

            _prep_gate = (_MF['ob'] is not None and _MF['ob'].phase == 'PREP')
            _shop_on = _SHOPV['open'] and _MF['ob'] is not None
            _gate = _shop_on or _prep_gate
            # ★★ 2026-10-28：双方就绪、本局没买实体件 -> 调整界面（状态由
            #   MatchFlow.adjust 驱动；这里同步画面/按键状态并关商店）。
            _adj_sync(_MF['ob'])
            if _ADJ['on']:
                _shop_on = False
            # ★★ 2026-10-28 用户定案：局前可摆放/调整；开局（PLAY）锁定
            _phase = (_MF['ob'].phase if _MF['ob'] is not None else None)
            if _PBUY['on'] and _phase != 'PREP':
                _PBUY['on'] = False              # 离开局前：询问自动作废（道具保留）
            if _phase not in ('PLAY', 'PLACE') and _PHYS.get('lock'):
                _PHYS['lock'] = False
                _PHYS['lock_obs'] = []
                _PHYS['lock_ports'] = []
                _PHYS['lock_holes'] = []
                print('[实物] 局前：障碍/传送门解锁（可摆放/调整）', flush=True)
            # ★ 2026-10-25：开局/离开局前时，实体布置态自动取消（额度不扣）
            if (_PPLACE['on'] and _MF['ob'] is not None
                    and _MF['ob'].phase not in ('PREP', 'PLACE')):
                # ★ 2026-10-28 修：对局中摆放已改成 PLACE 暂停阶段，不能在这里
                #   被"离开局前"取消（此前就是这个守卫把临时摆放秒杀了）。
                _pplace_clear()
                _item_msg_set('当前阶段结束——布置取消（额度未扣）')
                print('[布置] 离开可布置阶段，实体布置自动取消（额度未扣）',
                      flush=True)
            # ★★ 2026-10-25 实体道具布置：局前（商店/入口画面）整段检测本来是
            #   跳过的（要光标丝滑），但摆放态必须看相机——按 0.3s 节拍只跑
            #   实物识别（黑条/绿门/黑球），够判"新件稳定出现了没"。
            if (_PPLACE['on'] or (_gate and _ADJ['on'])) and v3_mod is not None:
                _tp = time.time()
                _det_holder = _PPLACE if _PPLACE['on'] else _ADJ
                if _tp - float(_det_holder.get('t_det') or 0.0) >= PHYS_PLACE_DET:
                    _det_holder['t_det'] = _tp
                    try:
                        # ★★ 2026-10-28 用户实况（"全分辨率识别差、还出假球"）：
                        #   **回缩略图识别**（8x8 平均把木纹/阴影抹掉，稳定），
                        #   摆放态用 loose=True 放宽小门/短条阈值。
                        _mbp = map_to_bgr(buf, swap ^ mswap)
                        _pd = _po.detect(_mbp, loose=True)
                        # ★★ 2026-10-30 用户定案：加洞口**不复用障碍/传送门
                        #   识别链**——只跑专用黑球检测（独立映射/过滤），
                        #   不调 `_phys_update`，不碰 bars/greens/世界/锁定副本。
                        if (_PPLACE.get('on')
                                and _PPLACE.get('kind') == 'hole'):
                            _PPLACE['hballs'] = _hole_balls_from_pd(
                                _pd, v3_mod, v3_H)
                        else:
                            _phys_update(v3_world, _pd, v3_mod,
                                         v3_H, _OBST,
                                         balls=[(getattr(_t, 'x', 0),
                                                 getattr(_t, 'y', 0),
                                                 getattr(_t, 'r', 0))
                                                for _t in _tracks])
                        #   摆放/调整改用**全分辨率原图**识别——缩略图 1 块=8 相机
                        #   像素，一对小绿门只有几像素，形状/面积都在阈值边缘。

                        if _PPLACE['on']:
                            _pplace_check(_MF['ob'], _tp, v3_world)
                            # ★ 对局中临时摆放：识别后把世界恢复成锁定副本
                            #   （新件只在黄框里预览，确认那一刻才写进锁定）
                            if (_PHYS.get('lock')
                                    and _MF['ob'] is not None
                                    and _MF['ob'].phase in ('PLAY', 'PLACE')):
                                _phys_apply_lock(v3_world)

                    except Exception as _epp:
                        _PHYS['nerr'] = int(_PHYS.get('nerr', 0)) + 1
                        if _PHYS['nerr'] <= 3:
                            print('[布置] ★ 实物识别异常（第 %d 次）：%s'
                                  % (_PHYS['nerr'], str(_epp)[:120]),
                                  flush=True)
            # ★★ 2026-10-15 加洞口 v2（用户实况："鼠标大漂移，不好控制"）：HOLE
            #   暂停期**全场冻结**——不抓相机、不检测、不跟踪（球/画面都不动），
            #   大屏换**俯视瞄准图**（合成画面，光标 20+fps 丝滑）。手机 json 的
            #   0.5s 节拍照旧（见下面的 elif）。
            _hole_on = (_MF['ob'] is not None and _MF['ob'].phase == 'HOLE')
            _edit_on = (_MF['ob'] is not None and _MF['ob'].phase == 'EDIT')
            n_frames += 1
            _FT.append(time.time())
            if len(_FT) > 31:
                _FT.pop(0)
            _rawg = None
            # ★★ 2026-10-13 提速二刀（用户："还是卡卡的，不够丝滑"）：**商店画面
            #   开着时**——地图→检测→坏帧熔断→选球/轨迹——**整段不跑**（合成画面
            #   没有消费者；球位店里冻结、开局跟踪器自然重锁）。地图读取与救援
            #   看门狗仍在上方每帧跑（不受影响）；n_frames 提到门外保 fps 账。
            #   ★ 2026-10-13 三刀：**局前（PREP）也算**——入口画面改成合成后同样
            #   不需要相机，进店前的光标一起丝滑（_gate = 店里 or 局前）。
            if not _gate and not _hole_on and not _edit_on:
                mbgr = map_to_bgr(buf, swap ^ mswap)
                # ★ 检测异常不再让整轮长跑崩掉（2026-09-29 凌晨：一次 absdiff 尺寸不匹配
                #   就把 60 秒的跑直接带走 —— 演示现场这种死法最不该有）。
                #   第一次连 traceback 一起打（好定位），之后只打一行；次数进汇总。
                try:
                    if _plmd is not None and bg_map is None:
                        # 差距 1：PL 已做完 掩码->OPEN->8连通；PS 只复判
                        _stats, _covf, _lovf, _pseq = _plmd.read_candidates()
                        if _pseq < 0:
                            raise RuntimeError('PL 候选读不稳定（SEQ 一直变）')
                        _hsv = cv2.cvtColor(mbgr, cv2.COLOR_BGR2HSV)
                        det, _nrej = detect_map_from_stats(_stats, _hsv,
                                                           _ring_median_fast)
                    elif bg_map is not None:
                        det, _nrej = detect_map_bg(mbgr, bg_map, _ring_median_fast,
                                                   max_area=map_max_area)
                    else:
                        det, _nrej = detect_map(mbgr, _ring_median_fast,
                                                max_area=map_max_area)
                except Exception as e:
                    _DET['n_err'] += 1
                    if _DET['n_err'] <= 3:
                        print('[检测] ★ 异常（第 %d 次）：%s' % (_DET['n_err'], str(e)[:140]),
                              flush=True)
                        if _DET['n_err'] == 1:
                            import traceback
                            traceback.print_exc()
                    continue
                t2 = time.perf_counter()
                t_det.append(t2 - t1)
                # ★★ 2026-10-19 实物识别：黑长条=障碍 / 绿椭圆=传送门 / 黑球=洞口标记
                #   （~1-2ms/帧；稳定性 0.4s 才生效，坏帧被跟踪器自然滤掉）
                if v3_mod is not None:
                    _tph0 = time.perf_counter()
                    if _PHYS.get('lock'):
                        # PLAY：障碍/传送门锁定——不再做实物识别（也省一笔）
                        _phys_apply_lock(v3_world)
                    else:
                        try:
                            _phys_update(v3_world, _po.detect(mbgr), v3_mod,
                                         v3_H, _OBST,
                                         balls=[(getattr(_t, 'x', 0),
                                                 getattr(_t, 'y', 0),
                                                 getattr(_t, 'r', 0))
                                                for _t in _tracks])
                            # ★ 第一帧 PLAY：用这一帧的稳定结果锁死，之后不变
                            #   ★ 必须等**免费基线**锁定（base_ready）后再锁：
                            #     否则 world.obstacles 还是空的 -> 锁成 0 根（2026-10-28 实锤）
                            if (_phase == 'PLAY'
                                    and _PHYS.get('base_ready')):
                                _phys_lock(v3_world)
                        except Exception as _eph:
                            _PHYS['nerr'] = int(_PHYS.get('nerr', 0)) + 1
                            if _PHYS['nerr'] <= 3:
                                print('[实物] 识别异常（第 %d 次）：%s'
                                      % (_PHYS['nerr'], str(_eph)[:120]),
                                      flush=True)
                    _ms_add('phys', _tph0)

                # ---- ★ 坏帧熔断（2026-09-29 夜，接屏幕前补的一环）----
                #   昨晚那趟 20fps 的跑里"球"每帧跳 ±600px、颜色报 black —— 那不是球，
                #   是**半死链路/撕裂**送来的垃圾地图。这种帧要是喂进 trail 和 V3：图是乱的、
                #   结论是假的，而且它还是**最贵**的帧（候选越多 classify_map 越慢）。
                #   判据 = 候选数 + 相邻行差两个证据一起看（见 frame_sane_map 的注释）。
                #   ★ 熔断的帧**仍然算有效帧**（循环确实读+检了一帧，fps 账要诚实），
                #     只是它的球不可信：不进球、不进轨迹、不喂 V3。
                _fused = False
                _ok, _why, _rc = frame_sane_map(mbgr, len(det) + _nrej)
                _DET['rc'].append(_rc)
                if len(_DET['rc']) > 500:
                    _DET['rc'].pop(0)
                if not _ok:
                    _fused = True
                    _DET['n_fuse'] += 1
                    if _DET['n_fuse'] <= 3:
                        print('[检测] ★ 坏帧熔断（第 %d 次）：%s -> 这帧不进球/不进 V3'
                              % (_DET['n_fuse'], _why), flush=True)

                # ---- 游戏逻辑：取最大的红/蓝球当"粒子"，算位置/速度/轨迹 ----
                #   ★★ 2026-10-01 夜（用户第②点）：**只认场区内的球**。
                #   上一趟的实测：手机支架（raw 顶部那两条，r≈68~73）靠"面积最大"在
                #   38% 的时间里抢走了目标；它的游戏坐标在场区**外**（=那 113 次"球在
                #   场区外跳过"）。球是要摆在**边界上**的，所以判据不能是"严格在场内"，
                #   而是"在场区外扩 track_margin 像素的框里"（默认 20px 起步，可调）。
                #   折算走 cam_to_game —— 与 V3 判定同一份标定，不可能出现两套映射。
                #   ★ 只在 --v3 开启时过滤（没场区/没标定就无从判"场外"，行为不变）。
                # ★★ 2026-10-05：**多目标追踪**（用户："多颗实物球各自被追踪"）。
                #   老实现"每帧挑面积最大"没有时间关联——两颗球面积一波就来回跳
                #   （实测 ±121px、轨迹锯齿，见 ball_tracker.py 文件头）。现在：
                #   · （场区过滤后的）候选每帧喂 MultiTracker：预测-关联 → 稳定轨迹；
                #   · "主球"（喂发射/速度拟合/HUD 的那颗）= 离最近边最近的**已确认**轨迹；
                #   · 全部轨迹交给直播画面：各自画圈 + 各自拖尾（按颜色）。
                ball = None
                _tracks = []
                _cand = []
                if det and not _fused:
                    _cand = det
                    if v3_mod is not None:
                        _cand, _rej = _track_filter(
                            v3_mod, v3_H, det, track_margin,
                            getattr(v3_world, 'obstacles', None))
                        if not _cand:
                            # 候选全在场区外：这一帧就当"画面里没球"（但账要记下来，
                            # 前 3 次把最大那个候选的坐标喊出来 —— 好核对是不是支架/网线）
                            V3_STAT['n_trk_rej'] += 1
                            if V3_STAT['n_trk_rej'] <= 3 and _rej is not None:
                                _b, (_gx, _gy) = _rej
                                print('[跟踪] 候选 %d 个全在场区外（最大者在游戏 %.0f,%.0f，'
                                      'r=%.0f %s）-> 本帧没球（容差 %.0fpx，--track-margin 调）'
                                      % (len(det), _gx, _gy, _b['r'], _b.get('cls'),
                                         track_margin), flush=True)
                _ttr0 = time.perf_counter()
                _tracks = trk.update(_cand, time.time())      # 空帧也要走（miss 计数）
                # ★ 2026-11-01 用户规则：障碍物本体 = **禁止识别球区**——已经
                #   关联上的轨迹若落在障碍物里（黑条挡住/误跟），从渲染/选球
                #   列表剔除；tracker 内部保留，球出来还能认回原号。
                if (_cand is not None and v3_mod is not None
                        and getattr(v3_world, 'obstacles', None)):
                    _tracks = [
                        _tk for _tk in _tracks
                        if not _in_obstacle_game(
                            *v3_mod.cam_to_game(v3_H, _tk.sx, _tk.sy)[:2],
                            v3_world.obstacles)]
                _ms_add('trk', _ttr0)
                # ★★ 2026-10-07（用户："序号重排时屏幕时有跳动"实锤：贴边球闪断->留位
                #   进出->活球的号被整体推来推去；而玩家高亮/预览/发射都按**号**锚定，
                #   号一换主，玩家的圈就跳到别的球上）：**选球跟着球走**——重排事件
                #   (Track, 旧号, 新号) 里若有玩家正控的号，自动跟到该球的新号；写回
                #   状态文件（手机同步）+ hub/本地同帧跟手（发射块这帧就用新号）。
                if v3_hub is not None:
                    for _to, _on, _nn in trk.take_renumber():
                        for _pk3, _cur3 in ((1, v3_ball1), (2, v3_ball2)):
                            if _on == _cur3:
                                print('[选球] ★ 重排跟随：P%d 控球 %d -> %d（跟着球走）'
                                      % (_pk3, _on, _nn), flush=True)
                                try:
                                    _v3in_write(player=_pk3, ball=_nn, src='game',
                                                path=_v3in_path)
                                except Exception:
                                    pass
                                if _pk3 == 1:
                                    v3_hub.ball1 = _nn
                                    v3_ball1 = _nn
                                else:
                                    v3_hub.ball2 = _nn
                                    v3_ball2 = _nn
                # ★ 2026-10-05 夜：候选清单周期日志（15s 一行）——多球排查时 tail 一眼看全
                if time.time() - _DBG['t'] > 15.0:
                    _DBG['t'] = time.time()
                    print('[检测] 候选 %d 个: %s' % (len(_cand),
                          ' '.join('%s@(%.0f,%.0f)' % (c.get('cls'), c['x'], c['y'])
                                   for c in _cand[:6])), flush=True)
                # ★ 2026-10-06（用户："网页应该实时刷新有几个球的序号"）：把"场上现在
                #   有几号球（含颜色）"写出来给手机网页（动态选球按钮）。0.5s 限频、
                #   原子写、失败不抛（网页顶多少一行列表）。
                # ★★ 2026-10-16：节拍抽成 _phone_state_tick——正常检测路径与 HOLE
                #   冻结路径**共用同一份**（冻结期检测全跳过，只有这个节拍必须活着；
                #   两份实现不许存在——同"门变量只许一个来源"的教训）。
                if time.time() - _BALLS['t'] > 0.5:
                    _phone_state_tick(_MF['ob'], _MF['mod'], v3_world,
                                      _SHOPV['open'], live_balls, _tracks,
                                      v3_mod, v3_H)
                if _tracks:
                    # ★ 2026-10-23：主球优先**红/蓝**已确认轨迹（黑球=洞口标记/手影，
                    #   不该抢主球；否则 V3/轨迹会跟着黑球标记跳到边缘）
                    _conf = ([t for t in _tracks
                              if t.no is not None and t.cls in ('red', 'blue')]
                             or [t for t in _tracks if t.no is not None]
                             or [t for t in _tracks
                                 if t.confirmed and t.cls in ('red', 'blue')]
                             or [t for t in _tracks if t.confirmed] or _tracks)
                    if v3_mod is not None:
                        def _edge_dist(t):
                            _gx, _gy = v3_mod.cam_to_game(v3_H, t.x, t.y)[:2]
                            return min(_gx, v3_mod.FIELD_W - _gx,
                                       _gy, v3_mod.FIELD_H - _gy)
                        _prim = min(_conf, key=_edge_dist)
                    else:
                        _prim = _conf[0]                      # 已按 area 降序
                    ball = dict(x=_prim.sx, y=_prim.sy, r=_prim.sr, cls=_prim.cls)
                    n_hit += 1
                    # ★ 2026-10-23 实况（用户晃手）：手被当成假黑球，跟踪器跳到
                    #   远处 -> 历史轨迹把两次位置连成横跨屏幕的绿线。跳变即清空，
                    #   不让轨迹跨过"换目标"的那一跳。
                    if trail:
                        _jdx = ball['x'] - trail[-1][0]
                        _jdy = ball['y'] - trail[-1][1]
                        if _jdx * _jdx + _jdy * _jdy > 250.0 * 250.0:
                            trail.clear()
                    trail.append((ball['x'], ball['y'], ball['cls'], time.time()))
                    if len(trail) > trail_len:
                        trail.pop(0)

            elif (_hole_on or _edit_on) and time.time() - _BALLS['t'] > 0.5:
                # ★★ 2026-10-16 加洞口 v2：HOLE 冻结期的**最小节拍**——检测/跟踪
                #   全跳过（全场冻结、画面不动，球位用冻结前快照），只保持手机
                #   json 活着（手机俯视图 + 状态栏 0.5s 一刷，不刷就"死了"）。
                _phone_state_tick(_MF['ob'], _MF['mod'], v3_world,
                                  _SHOPV['open'], live_balls, _tracks,
                                  v3_mod, v3_H)

            # ---- ★ 2026-10-06 M2.1：**选球键**（P1=Z/X、P2=,/.；循环控球编号）----
            #   读上升沿（与 fire 同口径，文件重建只对基准）；在**当前场上的号**
            #   里循环（-1=上一颗 / +1=下一颗，回绕）；结果写回状态文件（手机页面
            #   同步显示）+ 本地立即生效；没有号（场上无球）时忽略。
            if v3_hub is not None:
                for _pk, _up, _dn in ((1, v3_hub.sup1, v3_hub.sdn1),
                                      (2, v3_hub.sup2, v3_hub.sdn2)):
                    for _lk, _cnt, _dlt in (('sup%d' % _pk, _up, 1),
                                            ('sdn%d' % _pk, _dn, -1)):
                        if _cnt < _SEL[_lk]:
                            _SEL[_lk] = _cnt            # 文件重建：只对基准
                            continue
                        if _cnt == _SEL[_lk]:
                            continue
                        _SEL[_lk] = _cnt
                        # ★ 2026-10-29：改磁场输数值时，'.' 是小数点
                        if (_MF['ob'] is not None
                                and _MF['ob'].phase == 'EDIT'):
                            continue
                        _nums = sorted(int(t.no) for t in _tracks
                                       if t.no is not None)
                        if not _nums:
                            continue
                        _cur = v3_hub.ball1 if _pk == 1 else v3_hub.ball2
                        _ix = _nums.index(_cur) if _cur in _nums else 0
                        _new = _nums[(_ix + _dlt) % len(_nums)]
                        if _new == _cur:
                            continue
                        try:
                            _v3in_write(player=_pk, ball=_new, src='key',
                                        path=_v3in_path)
                        except Exception as _ew:
                            # ★ 不许静默（2026-10-06 教训：就是静默吞异常让
                            #   "选球永远停在 1"查了半天）——首次大声报，之后安静。
                            if not _SEL.get('warned'):
                                _SEL['warned'] = True
                                print('[选球] ★ 写回状态文件失败（仅提醒一次）：%s'
                                      % str(_ew)[:140], flush=True)
                        # ★★ 2026-10-06（"切到3球发射却不是3球的位置"的根因）：
                        #   发射块读的是**循环开头**拍的快照 `v3_ball1/2`——而"切球→
                        #   马上按发射"间隔常小于一帧（当前 ~650ms/帧），两者落进同
                        #   一帧时，发射还在用帧头的旧号。这里**同帧同步**本地快照。
                        if _pk == 1:
                            v3_hub.ball1 = _new
                            v3_ball1 = _new
                        else:
                            v3_hub.ball2 = _new
                            v3_ball2 = _new
                        print('[选球] P%d 控球 %s -> %s（键盘）'
                              % (_pk, _cur, _new), flush=True)

            # ---- ★★ M2.2 局状态机推进（--match）-----------------------------
            #   30s 洞口计时 / 结算 2.6s→下一局 / 平局加赛 / 暂停超时；事件用
            #   drain() 取走：round_start = **清场**（规则书 §3"本局结束场上剩余
            #   粒子全部清场"）。dt 卡顿后封顶 0.5s（别让一觉醒来跳三局）。
            if _MF['ob'] is not None:
                _mnow = time.time()
                if _MF['t'] is None:
                    _MF['t'] = _mnow
                _mdt = min(0.5, _mnow - _MF['t'])
                _MF['t'] = _mnow
                if _mdt > 0:
                    _MF['ob'].update(_mdt)
                for _mev in _MF['ob'].drain():
                    if _mev[0] == 'round_start':
                        # ★★ 2026-11-01 用户规则订正：**实球跨局保留**（v5 的
                        #   "在飞续局"恢复）——上一局还没出射的球冻结在场上，
                        #   新局从中接着飞（LiveBall.who 记发球人，进球仍算他的分）。
                        #   只清掉已死/出射残影；洞口随机的前视否决仍用 live_balls
                        #   （v5 同一套：在飞球可能正压着新洞位）。
                        _nold = len(live_balls)
                        live_balls[:] = [b for b in live_balls if b.alive]
                        _nkeep = len(live_balls)
                        _STEP['t'] = None               # 真球计时基准同步重置
                        _REV['img'] = None              # 复盘图不留到下一局
                        _REV['until'] = 0.0
                        _REV['prev'] = False
                        for _k in _HITS:                # ★ M2.4：落点账"本局"口径
                            _HITS[_k].clear()
                        # ★★ 2026-10-07（规则书 §1："第 n 局 n 块、封顶 9"）：本局按
                        #   局数**重建磁场分块**——PL 场表 NBLK=9 早就在位（纯软件
                        #   重写场景，不动 RTL）；b_fix=±0.4 隔块交替沿用演示口径，
                        #   seed 固定 = 同 n 的布局可复现。真球物理每帧、PL 预览每次
                        #   扫描、画面都从 v3_world **现取**——三处自动同步。必须在
                        #   洞口随机**之前**重建（新世界的洞才是要随机的对象）。
                        _nb = min(int(_mev[1]), 9)
                        v3_world = _norm_holes(
                            _vs.build_world(v3_seed, v3_b, n_blocks=_nb))
                        v3_world.obstacles = _OBST    # ★ 布置 PLACE：障碍"永久"跨局保留
                        print('[对局] 本局磁场：%d 块（±%.2f 隔块交替）'
                              % (len(v3_world.blocks), v3_b), flush=True)
                        # ★ 用户 2026-10-07："每一局的洞口希望是随机的"（规则书 §2
                        #   本就是"电脑设置本局磁场与洞口"）。掷新位 -> 2 秒前视
                        #   否决（v5 续局的在飞球可能正压着新洞位——被否就保留原值）
                        #   -> 应用并记"醒目动画"（与 30s 挪步同一套视觉）。
                        _flds3 = [(bb.x0, bb.y0, bb.x1, bb.y1, bb.b)
                                  for bb in v3_world.blocks]
                        _rp = _ha.random_positions(
                            v3_world.holes, v3_mod.FIELD_W, v3_mod.FIELD_H,
                            getattr(v3_mod, 'CORNER_R', 0.0))
                        _rj = []
                        for _hi, _nc in _rp:
                            _cand = [dict(h) for h in v3_world.holes]
                            _cand[_hi]['c'] = _nc
                            if _ha.would_score_within(live_balls, _cand, _flds3):
                                continue
                            _old = v3_world.holes[_hi]['c']
                            v3_world.holes[_hi]['c'] = _nc
                            _rj.append((v3_world.holes[_hi]['edge'], _old, _nc))
                        if _rj:
                            _HMOVE['t'] = time.time()
                            _HMOVE['items'] = _rj
                            print('[对局] 本局洞口随机：%s' % '、'.join(
                                '%s %.0f->%.0f' % (e, o, n) for e, o, n in _rj),
                                flush=True)
                        print('[对局] ★★ 第 %d 局开始（续局：保留上一局 %d 颗实球，清掉 %d 颗死球）%s'
                              % (_mev[1], _nkeep, _nold - _nkeep,
                                 '（加赛）' if _mev[2] == 'tiebreak' else ''),
                              flush=True)
                    elif _mev[0] == 'place_timeout':
                        if _PPLACE['on']:
                            _pplace_clear()
                            _item_msg_set('摆放超时（30秒）——已取消（额度未扣）')
                            print('[布置] 对局中摆放超时（30s）——取消（额度未扣）',
                                  flush=True)
                    elif _mev[0] == 'match_end':
                        print('[对局] ★★★ 比赛结束：%s' % _MF['ob'].result_text(),
                              flush=True)
                    elif _mev[0] == 'ammo_done':
                        print('[对局] 双方弹药打光——等场上球落定 %d 秒'
                              '（期间进球照算）' % int(_MF['mod'].GRACE_SECS),
                              flush=True)
                    elif _mev[0] == 'round_over':
                        _nfly = sum(1 for b in live_balls if b.alive)
                        print('[对局] 本局结算%s' % (
                            '；%d 颗球还在飞 -> 下一局原轨迹续飞' % _nfly
                            if _nfly else ''), flush=True)
                    elif _mev[0] == 'hole_due':
                        if _PHYS.get('mark_on'):
                            # ★ 2026-10-19：桌上有黑洞标记 -> 洞位置由实物说了算，
                            #   自适应让位（清落点账，保持"每 30s 重新计"的口径）。
                            print('[对局] 黑洞标记在场：洞自适应让位（不动洞）',
                                  flush=True)
                            for _k5 in _HITS:
                                _HITS[_k5] = []
                            continue
                        # ★★ M2.4（规则书 §8）：30 秒无进球 -> 洞口朝**该侧落点热点**
                        #   移动一小步。计划+边界/重叠约束在 hole_adapt.pick_moves；
                        #   逐条做 **2 秒前视否决**（会让在飞真球直接进洞的移动作废——
                        #   克隆步进，与真球物理逐位同源）。移动 = 改
                        #   `v3_world.holes[i]['c']`：真球每帧吃同一份 dict、PL 预览
                        #   每次扫描都 write_scene 重写洞表、画面直读世界——三处自动
                        #   同步。**无论移没移，本段落点账清空**（engine 同款："本局
                        #   累计"重新从这 30 秒算起）。
                        _flds2 = [(bb.x0, bb.y0, bb.x1, bb.y1, bb.b)
                                  for bb in v3_world.blocks]
                        _n_hits = '/'.join('%s%d' % (_k, len(_HITS[_k]))
                                           for _k in ('left', 'right'))
                        _mv = _ha.pick_moves(v3_world.holes, _HITS,
                                             v3_mod.FIELD_W, v3_mod.FIELD_H,
                                             getattr(v3_mod, 'CORNER_R', 0.0))
                        _moved, _veto = [], 0
                        _flash = []
                        for _hi, _nc in _mv:
                            _cand = [dict(h) for h in v3_world.holes]
                            _cand[_hi]['c'] = _nc
                            if _ha.would_score_within(live_balls, _cand, _flds2):
                                _veto += 1
                                continue
                            _old = v3_world.holes[_hi]['c']
                            v3_world.holes[_hi]['c'] = _nc
                            _moved.append('%s->%.0f' % (v3_world.holes[_hi]['edge'], _nc))
                            _flash.append((v3_world.holes[_hi]['edge'], _old, _nc))
                        if _flash:                      # ★ 醒目动画（3 秒）
                            _HMOVE['t'] = time.time()
                            _HMOVE['items'] = _flash
                        for _k in _HITS:
                            _HITS[_k].clear()
                        print('[对局] 30s 无进球 -> 洞口%s（落点 %s；计划 %d，前视否决 %d）'
                              % ('移动：' + '、'.join(_moved) if _moved else '评估后不动',
                                 _n_hits, len(_mv), _veto), flush=True)
                    elif _mev[0] == 'edit_timeout':
                        # ★ 2026-10-29 三步确认：match_flow 只在 VALUE 阶段自动
                        #   确认（end_edit(confirm=True)）；SELECT/DIR 超时=取消、
                        #   不扣额度——这里只负责把输入的数值落到块。
                        _done2 = bool(_mev[2]) if len(_mev) > 2 else True
                        if _done2:
                            try:
                                if _MF['ob'].edit.get('stage') == 'VALUE':
                                    _bv2 = _edit_apply_value(_MF['ob'], v3_world)
                                    print('[对局] ★ P%d 改磁场超时——按输入值生效 '
                                          'B=%+.2f' % (_mev[1], _bv2 or 0.0),
                                          flush=True)
                            except Exception:
                                pass
                            _item_msg_set('改磁场超时——按输入值生效')
                        else:
                            _item_msg_set('改磁场超时未完成——本次取消（不扣额度）')
                        _MAS['snap'] = None
                        _edit_restore()
                        print('[对局] ★ P%d 改磁场暂停超 30s，%s'
                              '（规则书 §7.1-5）'
                              % (_mev[1], '自动确认恢复' if _done2
                                 else '未到数值阶段 -> 取消，不扣额度'),
                              flush=True)
                    elif _mev[0] == 'hole_timeout':
                        # ★ 2026-10-14（规则书 §7）：加洞口 30s 上限。超时怎么收
                        #   由这里定夺。★★ 2026-10-16 收紧（用户实况："按 ESC 退出
                        #   后也算次数了？"）：**只有"确认过位置"（confirm=True——
                        #   点击过/手机点过）才自动放置（扣额度）**；只是晃了鼠标
                        #   从没点过、或位置不合法 -> 一律取消、**不扣**。
                        #   两种结局都上横幅 + 回手机——此前超时放置是**静默**的，
                        #   "次数怎么没了"根本没处问。
                        _hk2 = _MF['ob']
                        _who2 = _hk2.hole['player']
                        _ed4, _ps4 = (_hk2.hole['edge'], float(_hk2.hole['pos']))
                        _fine2 = (_hk2.hole.get('stage') == 'FINE')
                        if (_HOLEV['confirm'] and _fine2
                                and _hole_valid(v3_world, _ed4, _ps4)):
                            _hole_commit(_hk2, v3_world)
                            _item_msg_set('加洞口超时（30秒）——已自动放置'
                                          '（%s %.0f）' % (_ed4, _ps4))
                            print('[道具] ★ 30s 超时自动放置（P%d %s %.0f）'
                                  % (_who2, _ed4, _ps4), flush=True)
                            _shot_write(dict(t=round(time.time(), 3), ok=True,
                                             why='item', kind='item', seq=0,
                                             msg='P%d 加洞口(%s %.0f)'
                                                 % (_who2, _ed4, _ps4)),
                                        player=_who2)
                        else:
                            _hk2.end_hole(cancel=True)
                            _item_msg_set('加洞口超时（30秒）——已取消，没有扣额度')
                            print('[道具] ★ 30s 超时取消（%s）'
                                  % ('位置放不下' if _fine2
                                     else '只晃了鼠标、没点过位置'), flush=True)
                            _shot_write(dict(t=round(time.time(), 3), ok=True,
                                             why='item', kind='item', seq=0,
                                             msg='P%d 加洞口超时取消（没扣额度）'
                                                 % _who2), player=_who2)
                        _holev_clear()

            # ---- ★★ 2026-10-08 局前选购（道具系统 v1，规则书 §6.2）------------
            #   同键双语义：W/S/↑↓ 局中是角度键、**局前=选单上下**（v3_input 记
            #   p{N}_mup/mdn 计数器）；E / 小键盘*=购买。这里读**上升沿**（计数器
            #   变低=文件重建，只对基准）；结果播报 + 写 shot.json（手机"最近一杆"
            #   可见）。动作本身走纯函数 _shop_apply（台架可测）。
            if _MF['ob'] is not None and v3_hub is not None:
                for _pk, _evs in ((1, (('mup', v3_hub.mup1), ('mdn', v3_hub.mdn1),
                                       ('buy', v3_hub.buy1))),
                                  (2, (('mup', v3_hub.mup2), ('mdn', v3_hub.mdn2),
                                       ('buy', v3_hub.buy2)))):
                    for _act, _cnt in _evs:
                        _k = '%s%d' % (_act, _pk)
                        if _cnt < _SHOP[_k]:
                            _SHOP[_k] = _cnt              # 文件重建：只对基准
                            continue
                        if _cnt == _SHOP[_k]:
                            continue
                        _SHOP[_k] = _cnt
                        # ★★★ 2026-10-14 修（10-13 提速时埋的基准 staleness bug）：
                        #   相位门必须放在**基准更新之后**——否则局中按 E/W 不更新
                        #   基准，计数器居高不下，回到局前第一帧会被当成一次新按键
                        #   **误买/误挪**。这里 _SHOP[_k] 已在上面无条件对齐。
                        if _MF['ob'].phase != 'PREP':
                            continue
                        # ★★ 2026-10-28（第 3 条）：购买询问未答复时，只认
                        #   "买家再按一次购买键"= 立即摆放；其余按键先搁置。
                        if _PBUY['on']:
                            if (_act == 'buy' and _pk == _PBUY['who']
                                    and _cnt > int(_PBUY['b'])):
                                _pbu_resolve(_MF['ob'], True)
                            continue
                        # ★ 2026-10-27 实体布置态：E 走下面 cfm 确认链，W/S 不导航商店
                        #   （这里只消费基准，防 E 同时误买）。
                        if _PPLACE['on']:
                            continue
                        # ★ 2026-10-28 调整界面：E/小键盘* 是「开始本局」，
                        #   走下面 cfm 链；这里只消费基准，不重开商店。
                        if _ADJ['on']:
                            continue
                        # ★ 2026-10-19 布置 PLACE v1：摆放态里 W/S=**旋转**、E=确定
                        #   （E 的消费统一走下面 cfm 链——这里只拦商店动作，防双吃）。
                        if _OBSP['on']:
                            if _OBSP['who'] == _pk and _act in ('mup', 'mdn'):
                                _dsp = (OBS_ANG_STEP if _act == 'mup'
                                        else -OBS_ANG_STEP)
                                _OBSP['ang'] = (_OBSP['ang'] + _dsp) % 180.0
                                _item_msg_set('障碍角度 %.0f°（绿=可放/红=放不下）'
                                              % _OBSP['ang'])
                            continue
                        if not _SHOPV['open']:
                            if _act == 'buy':
                                _SHOPV['open'] = True
                                print('[商店] 进入商店画面（P%d 按了购买键）' % _pk,
                                      flush=True)
                            continue
                        _shopmsg = _shop_apply(_MF['ob'], _pk, _act)
                        if _shopmsg:
                            print('[选购] P%d %s：%s' % (_pk, _act, _shopmsg),
                                  flush=True)
                            _shot_write(dict(t=round(time.time(), 3), ok=True,
                                             why='shop', kind='shop', seq=_cnt,
                                             msg='P%d %s' % (_pk, _shopmsg)),
                                        player=_pk)
                        # ★ 2026-10-28 用户定案（第 3 条）：买完先问要不要现在用
                        if _act == 'buy':
                            _shop_ask_use(_MF['ob'], _pk, _cnt,
                                          getattr(v3_hub, 'esc', 0))
                # ---- ★★ 2026-10-25 实体道具布置：V/小键盘- = 障碍；G/小键盘7 = 传送门 ----
                #   用户定案：摆的是**实体件**（相机识别）。局前买道具 -> 按键进入
                #   摆放 -> 实体黑条/一对绿门稳定识别 -> 扣 1 次并生效（永久）；
                #   ESC 取消不扣。开局就在桌上的实体件是免费基线，不受这个门限制。
                #   再按同一个键 = 退出（不扣额）。
                for _pk, _cnt2, _kind, _kn in (
                        (1, getattr(v3_hub, 'obs1', 0), 'obstacle', 'V'),
                        (2, getattr(v3_hub, 'obs2', 0), 'obstacle', '小键盘-'),
                        (1, getattr(v3_hub, 'ppl1', 0), 'portal', 'G'),
                        (2, getattr(v3_hub, 'ppl2', 0), 'portal', '小键盘7')):
                    _k = ('obs%d' if _kind == 'obstacle' else 'ppl%d') % _pk
                    if _cnt2 < _SHOP[_k]:
                        _SHOP[_k] = _cnt2                   # 文件重建：只对基准
                        continue
                    if _cnt2 == _SHOP[_k]:
                        continue
                    _SHOP[_k] = _cnt2
                    # ★ 2026-10-29：改磁场输数值时，小键盘 7/8 是数字 7/8
                    if (_MF['ob'] is not None
                            and _MF['ob'].phase == 'EDIT'
                            and _MF['ob'].edit.get('stage') == 'VALUE'):
                        continue
                    _cn = '障碍' if _kind == 'obstacle' else '传送门'
                    if _MF['ob'].phase not in ('PREP', 'PLAY'):
                        # ★ 2026-10-28（第 3 条）：对局中也能临时加；只有暂停/
                        #   结算阶段不能摆。
                        print('[布置] P%d 按 %s：当前阶段不能摆放——道具保留'
                              % (_pk, _cn), flush=True)
                        _item_msg_set('当前阶段不能摆放——道具保留')
                        continue
                    if _PPLACE['on']:
                        if _PPLACE['who'] == _pk \
                                and _PPLACE['kind'] == _kind:
                            _pplace_clear()
                            _item_msg_set('已退出布置（额度未扣）')
                            print('[布置] P%d 退出%s摆放（额度未扣）'
                                  % (_pk, _cn), flush=True)
                        continue
                    _okp, _pm = _pplace_enter(_MF['ob'], _pk, _kind)
                    print('[布置] %s' % _pm, flush=True)
                    _item_msg_set(_pm)
                    if _okp:
                        print('[布置] P%d 按 %s 进入%s摆放（实体件识别）'
                              % (_pk, _kn, _cn), flush=True)

                # ---- ★★ 商店 v2：手机「进入商店」键 + 鼠标左键 ------------------
                for _pk, _sc in ((1, getattr(v3_hub, 'sopen1', 0)),
                                 (2, getattr(v3_hub, 'sopen2', 0))):
                    _k = 'sopen%d' % _pk
                    if _sc < _SHOP[_k]:
                        _SHOP[_k] = _sc
                        continue
                    if _sc == _SHOP[_k]:
                        continue
                    _SHOP[_k] = _sc
                    if _MF['ob'].phase == 'PREP' and not _SHOPV['open']:
                        _SHOPV['open'] = True
                        print('[商店] 进入商店画面（手机 P%d 按了"进入商店"）' % _pk,
                              flush=True)
                _mc = int(getattr(v3_hub, 'mbtn', 0) or 0)
                if _mc < _SHOP['mbtn']:
                    _SHOP['mbtn'] = _mc                   # 文件重建：只对基准
                elif _mc > _SHOP['mbtn']:
                    _SHOP['mbtn'] = _mc
                    # ★★ 2026-10-27 实体布置点选：布置态左键先归它（点黑条锁定），
                    #   不消费才走洞口/虚拟障碍/商店。
                    _hit = None
                    if _pbuy_mouse_click(v3_hub.mx, v3_hub.my,
                                         v3_pump.width, v3_pump.height,
                                         _MF['ob']):
                        pass
                    elif _PPLACE['on']:
                        _pplace_mouse_click(v3_hub.mx, v3_hub.my, v3_H,
                                            v3_pump.width, v3_pump.height,
                                            crop_margin)
                    # ★★ 2026-10-15 加洞口 v2：这一笔先给洞口流程（弹窗按钮 /
                    #   定住位置）；没消费（不在 HOLE）才走商店命中框。
                    #   相位互斥（HOLE vs PREP），两边不会打架。
                    elif _edit_mouse_hit(_MF['ob'], v3_hub,
                                         v3_pump.width, v3_pump.height,
                                         v3_world):
                        pass
                    elif _hole_mouse_click(_MF['ob'], v3_hub, v3_pump, v3_H,
                                           v3_mod, v3_world,
                                           _MF['mod']) is None:
                        if not _obsp_mouse_click(v3_hub, v3_world):
                            _hit = _shop_click(v3_hub.mx, v3_hub.my,
                                               _SHOPV['rects'])
                    if _hit == 'ent':
                        if _MF['ob'].phase == 'PREP':
                            _SHOPV['open'] = True
                            print('[商店] 进入商店画面（鼠标点击入口）', flush=True)
                    elif _hit and _hit[0] == 'p' and _SHOPV['open'] \
                            and _MF['ob'].phase == 'PREP':
                        _pk2, _rest = int(_hit[1]), _hit[2:]
                        if _rest.startswith('_it'):
                            if _MF['ob'].sub[_pk2] == 'SHOP':
                                _MF['ob'].sel_item[_pk2] = int(_rest[3:])
                                print('[选购] P%d 点选：%s'
                                      % (_pk2, _MF['ob'].shop_label(_pk2)),
                                      flush=True)
                        elif _rest == '_buy':
                            _msg = _shop_apply(_MF['ob'], _pk2, 'buy')
                            if _msg:
                                print('[选购] P%d 点买：%s' % (_pk2, _msg),
                                      flush=True)
                                _shot_write(dict(t=round(time.time(), 3),
                                                 ok=True, why='shop',
                                                 kind='shop', seq=_mc,
                                                 msg='P%d %s' % (_pk2, _msg)),
                                            player=_pk2)
                            # ★ 2026-10-28（第 3 条）：买完实体件先问要不要现在用
                            _shop_ask_use(_MF['ob'], _pk2,
                                          v3_hub.buy1 if _pk2 == 1
                                          else v3_hub.buy2,
                                          getattr(v3_hub, 'esc', 0))
                        elif _rest == '_done':
                            _MF['ob'].ready(_pk2)
                            _both2 = (_MF['ob'].phase == 'PLAY')
                            _adj3 = bool(getattr(_MF['ob'], 'adjust', False))
                            _why3 = ('双方就绪，开局！' if _both2
                                     else ('双方就绪——进入调整界面' if _adj3
                                           else '等对方就绪'))
                            print('[对局] P%d 点「完成」= 就绪（%s）'
                                  % (_pk2, _why3), flush=True)
                            _shot_write(dict(t=round(time.time(), 3), ok=True,
                                             why='ready', kind='ready',
                                             seq=_mc,
                                             msg=('P%d 已就绪——%s' % (
                                                 _pk2, _why3)),
                                        player=_pk2))
            # ★ 开局（含加赛局）自动关商店画面；非对局/回放也关
            if _SHOPV['open'] and (_MF['ob'] is None
                                   or _MF['ob'].phase != 'PREP'):
                _SHOPV['open'] = False

            # ---- ★★ 发射模式（2026-10-01 深夜，用户①②③三条）----------------
            #   输入层开着就是发射模式：
            #     · 平时**一帧都不预测**（下面那个周期预测块被 `v3_hub is None` 挡掉）；
            #     · 手机"发射"（大按钮）/ 键盘空格 -> 状态文件 fire 计数 +1 ->
            #       这里读**上升沿**发一杆：从**球当前所在的那条边**出发、方向 =
            #       边法线 + 输入角（规则表 v4：入射角以边界法线为 0°）。★★ 2026-10-05
            #       规则订正（用户定案）：**发射 = 真球入场**——球留场里一直飞，撞边界
            #       镜面反射，弹到出射（进洞）为止；多球共存、球球弹性反弹（规则书 §3）。
            #       物理 = realtime_ball，与瞄准预览 lane_fixed **逐位一致**。
            #     · ★★ 2026-10-28 用户定案：取消"区域中间拒绝"与紫色可发射带；
            #       球在红色场区内任意位置都可识别/初始/发射（球身压场区即可），
            #       方向仍 = 最近那条边的法线 + 输入角。
            #   ★ 冷却 1.5s：连点不许把游戏循环打穿（跟踪才是主线）。
            #   ★ 计数**变低**（文件被重建：serve 重启/换路径）= 只把基准对回去，
            #     **绝不**当成一次发射（宁可不发，也不发一杆莫名其妙的）。
            if v3_hub is not None:
                # ★★ 2026-10-05 双人（用户："网页改双人控制"）：两个玩家**各自读
                #   上升沿**（P1=fire / P2=fire2），各自用**自己那颗球**（编号 1/2
                #   的轨迹）+ 自己的角度/速度；冷却、拒因、结果全按玩家分开记。
                for _pk, _fcnt, _pang, _pspd, _pbno in (
                        (1, v3_hub.fire, v3_angle, v3_speed, v3_ball1),
                        (2, v3_hub.fire2, v3_angle2, v3_speed2, v3_ball2)):
                    _lk = 'last%d' % _pk
                    if _fcnt < _FIRE[_lk]:
                        _FIRE[_lk] = _fcnt               # 文件重建：只对基准，不发射
                        continue
                    if _fcnt == _FIRE[_lk]:
                        continue
                    _FIRE[_lk] = _fcnt
                    _now_f = time.time()
                    # ★★ M2.2：局前（PREP）里双方各自的发射键 = **就绪**键
                    #   （规则书 §6.2"双方都按才开局"；空格/回车本来就在手上，
                    #   局前本来也不许发射 —— 语义不冲突）。
                    if _MF['ob'] is not None and _MF['ob'].phase == 'PREP':
                        # ★★ 2026-10-28：调整界面里，发射键 = 「开始本局」
                        #   （但先把手上这次摆放收尾——别把布置态带进对局）
                        if _ADJ['on']:
                            if _PPLACE['on']:
                                _item_msg_set('先完成/退出这次摆放，再开始本局')
                                continue
                            _adj_start(_MF['ob'], _pk, v3_world)
                            continue
                        _MF['ob'].ready(_pk)
                        _both = (_MF['ob'].phase == 'PLAY')
                        _adj2 = bool(getattr(_MF['ob'], 'adjust', False))
                        if _both:
                            _why2 = '双方就绪，开局！'
                        elif _adj2:
                            _why2 = ('双方就绪——调整障碍/传送门后按 '
                                     'E / 小键盘* 开始本局')
                        else:
                            _why2 = ('等对方按「%s」就绪'
                                     % ('空格' if _pk == 1 else '回车'))
                        print('[对局] P%d 就绪（%s）' % (_pk, _why2), flush=True)
                        # ★ 2026-10-07 上板实玩发现（"按了发射没反应"的真身 = 局前里
                        #   发射键变成就绪键、却没有任何**玩家可见**的反馈）：就绪也写
                        #   一笔 shot.json —— 手机"最近一杆"直接显示谁已就绪、等谁。
                        _shot_write(dict(
                            t=round(_now_f, 3), ok=True, why='ready',
                            kind='ready', seq=_FIRE['n_req'],
                            msg=('P%d 已就绪——%s' % (_pk, _why2)),
                            player=_pk))
                        continue
                    if _now_f - _FIRE['t_last%d' % _pk] < 1.5:
                        _FIRE['n_cool'] += 1
                        print('[发射] P%d 距上一杆不足 1.5s -> 忽略这次点击' % _pk,
                              flush=True)
                        continue
                    _FIRE['n_req'] += 1
                    _pt = next((t for t in _tracks
                                if getattr(t, 'no', None) == _pbno), None)
                    _pball = (dict(x=_pt.sx, y=_pt.sy, r=_pt.sr, cls=_pt.cls)
                              if _pt is not None else None)
                    # ★★ M2.2 对局口径（--match）：暂停/结算中不许发；弹药按
                    #   **实物球颜色**（相机判色）扣 —— 没弹药也走同一条拒绝报告路
                    #   （控制台 + shot.json），玩家在手机上能看到为什么。
                    _mchg = (_rtb.charge_of(_pball['cls'])
                             if _pball is not None else 0)
                    if _MF['ob'] is not None:
                        _mok, _mwhy = _MF['ob'].can_fire(_pk, _mchg)
                        if not _mok:
                            _FIRE['n_' + _mwhy] += 1
                            _minfo = {'no_ammo': True,
                                      'red': _MF['ob'].ammo[_pk][1],
                                      'blue': _MF['ob'].ammo[_pk][-1]}
                            _m = ('P%d：' % _pk
                                  + _fire_msg(_mwhy, _minfo, fire_margin))
                            print('[发射] P%d #%d ★ 拒绝（%s）：%s'
                                  % (_pk, _FIRE['n_req'], _mwhy, _m), flush=True)
                            _shot_write(dict(t=round(_now_f, 3), ok=False,
                                             why=_mwhy, msg=_m,
                                             seq=_FIRE['n_req'],
                                             ang=round(_pang, 2),
                                             spd=round(_pspd, 1)),
                                        player=_pk)
                            continue
                    _okf, _why, _info = _fire_gate(v3_mod, v3_H, _pball,
                                                   _pang, fire_margin)
                    if not _okf:
                        _FIRE['n_' + _why] += 1
                        # ★ 2026-10-05 夜（"控球3按发射没反应"）：noball 有两半 ——
                        #   ①场上真没球（老文案对）②场上有球、但没有你选的这个
                        #   编号（文案必须说清"N 号不在、现在场上是几号"，老文案
                        #   还叫人"把球摆到边界上"，对第②种纯误导）。补 ② 的路标。
                        _info2 = _info
                        if _why == 'noball' and _tracks:
                            _info2 = dict(_info)
                            _info2['no_such'] = _pbno
                            _info2['have'] = sorted(int(t.no) for t in _tracks
                                                    if t.no is not None)
                        _m = ('P%d：' % _pk
                              + _fire_msg(_why, _info2, fire_margin))
                        print('[发射] P%d #%d ★ 拒绝（%s）：%s'
                              % (_pk, _FIRE['n_req'], _why, _m), flush=True)
                        _shot_write(dict(t=round(_now_f, 3), ok=False,
                                         why=_why, msg=_m,
                                         seq=_FIRE['n_req'],
                                         ang=round(_pang, 2),
                                         spd=round(_pspd, 1)),
                                    player=_pk)
                    else:
                        _FIRE['t_last%d' % _pk] = _now_f
                        _FIRE['n_ok'] += 1
                        # 发射 = 真球入场（2026-10-05 规则订正；与预览 lane_fixed
                        # 逐位一致，见 realtime_ball.py）
                        _b0 = _rtb.LiveBall(_info['bx'], _info['by'],
                                            _info['ang'], _pspd,
                                            seq=_FIRE['n_req'],
                                            charge=_rtb.charge_of(_pball['cls']),
                                            who=_pk)
                        if _MF['ob'] is not None:
                            _MF['ob'].consume(_pk, _mchg)   # ★ M2.2 按实物球颜色扣弹药
                        live_balls.append(_b0)
                        _LIVE_ST['n_fired'] += 1
                        _m = ('P%d（控球%d）#%d 在%s侧发射，角 %.1f°（0=右/逆时针）：'
                              '**真球已进场**（弹到出射为止；场上 %d 颗）'
                              % (_pk, _pbno, _FIRE['n_req'], _info['edge'],
                                 _info['ang_ui'], len(live_balls)))
                        if _info.get('snap'):
                            _m += '（球贴在线上，起点已自动收进边内）'
                        print('[发射] ★ %s' % _m, flush=True)
                        _shot_write(dict(
                            t=round(_now_f, 3), ok=True, why='', msg=_m,
                            seq=_FIRE['n_req'], edge=_info['edge'],
                            ang=round(_info['ang_ui'], 2),
                            spd=round(_pspd, 1),
                            bx=round(_info['bx'], 1),
                            by=round(_info['by'], 1),
                            d=round(_info['d'], 1), kind='live'),
                            player=_pk)

            # ---- ★★ 2026-10-14 局中道具（规则书 §6.4/§7.1）：改磁场 / 加洞口 ----
            #   发起 Q·小键盘. / C·小键盘+；ESC 取消；确认复用 E/小键盘*（buy 计数
            #   同键双语义：局前=购买、EDIT/HOLE=确认）；调参复用 W/S·↑↓（nav=方向）
            #   与 A/D·←→（nav2=强度/位置）。冻结/禁发射由 match 相位自带。
            if _MF['ob'] is not None and v3_hub is not None:
                _mob2 = _MF['ob']

                def _mas_ev(_k, _cnt):
                    """计数器上升沿（文件重建只对基准）。True=新一笔。

                    ★ 2026-10-25 第二次同款事故（aball1 KeyError 直接把游戏带崩）：
                      这里改用 _MAS.get(_k, 0)，**新增计数器忘了登记也不会崩**
                      （第一笔按 0 基准算上升沿，最多多消费一次，不会死）。
                    """
                    _cur = _MAS.get(_k, 0)
                    if _cnt < _cur:
                        _MAS[_k] = _cnt
                        return False
                    if _cnt == _cur:
                        return False
                    _MAS[_k] = _cnt
                    return True

                # ★ 2026-10-25 局中加球：F / 小键盘8——先打开串口屏选择页，
                #   触摸红/蓝后才扣 1 个「加球」道具（取消/超时不扣）。
                for _pk, _cntab in ((1, getattr(v3_hub, 'aball1', 0)),
                                    (2, getattr(v3_hub, 'aball2', 0))):
                    if not _mas_ev('aball%d' % _pk, _cntab):
                        continue
                    # ★ 2026-10-29：改磁场输数值时，数字 8 会走 aball2 别名
                    #   （小键盘/主键盘 8），别在这时弹"加球只能在对局中"
                    if (_MF['ob'] is not None
                            and _MF['ob'].phase == 'EDIT'
                            and _MF['ob'].edit.get('stage') == 'VALUE'):
                        continue
                    _okab, _msgab = _aball_begin(
                        _mob2, _pk, _screen_out if screen_on else None)
                    print('[道具] %s' % _msgab, flush=True)
                    _item_msg_set(_msgab)
                    if _okab:
                        _shot_write(dict(t=round(time.time(), 3), ok=True,
                                         why='item', kind='item', seq=0,
                                         msg=_msgab), player=_pk)

                for _pk, _evs in ((1, (('edit', v3_hub.edit1),
                                       ('hole', v3_hub.hole1))),
                                  (2, (('edit', v3_hub.edit2),
                                       ('hole', v3_hub.hole2)))):
                    for _act, _cnt in _evs:
                        if not _mas_ev('%s%d' % (_act, _pk), _cnt):
                            continue
                        if _mob2.phase == 'PLAY':
                            if _act == 'edit':
                                _okx, _msgx = _mob2.begin_edit(_pk)
                                if _okx:
                                    _MAS['snap'] = [(b, float(b.b))
                                                    for b in v3_world.blocks]
                                    # ★ 记录角度/速度快照（退出时还原，编辑键
                                    #   不污染对局的瞄准参数）+ 数字键基准
                                    _EDC['ang'] = (v3_angle, v3_speed,
                                                   v3_angle2, v3_speed2)
                                    for _i0 in range(10):
                                        _MAS['nd%d' % _i0] = int(
                                            v3_hub.nd[_i0] or 0)
                                    _MAS['nd7b'] = int(v3_hub.ppl2 or 0)
                                    _MAS['nd8b'] = int(v3_hub.aball2 or 0)
                                    _MAS['ndbk'] = int(v3_hub.nbksp or 0)
                                    _MAS['nddot'] = int(v3_hub.sup2 or 0)
                            else:
                                # ★★ 2026-10-30 用户定案：**加洞口 = 和障碍
                                #   完全同一套布置流程**——进 PLACE 暂停、实时
                                #   相机、0.3s 黑球识别、黄框、E/* 确认、ESC。
                                _okx, _msgx = _pplace_enter(
                                    _MF['ob'], _pk, 'hole')
                            if _msgx:
                                print('[道具] %s' % _msgx, flush=True)
                                _shot_write(dict(t=round(time.time(), 3), ok=True,
                                                 why='item', kind='item', seq=0,
                                                 msg=_msgx), player=_pk)
                        elif (_mob2.phase == 'EDIT'
                              and _mob2.edit['player'] == _pk
                              and _act == 'edit'):
                            # ★ 2026-10-29：EDIT 里这个键 = 小数点（输入数值用）
                            if _mob2.edit['stage'] == 'VALUE':
                                _mob2.edit_type('.')
                                print('[道具] P%d 输入：%s'
                                      % (_pk, _mob2.edit['txt']), flush=True)
                        elif (_mob2.phase == 'HOLE' and _act == 'hole'
                              and _mob2.hole['player'] == _pk):
                            if _HOLEV['mouse']:
                                # ★ 2026-10-16（用户："按 C 没反应"的真案例之一）：
                                #   鼠标接管中按 C —— 切边下一帧就被鼠标跟随覆盖
                                #   （隐形 no-op）。改为：**收回键盘控制**（C/E/ESC
                                #   全套可用）；动一下鼠标 >8px 可再交还鼠标。
                                _HOLEV['mouse'] = False
                                _HOLEV['m0'] = _HOLEV.get('last', (0, 0))
                                _item_msg_set('已切到键盘控制：C 切边 · E 定边/确认'
                                              '（动一下鼠标可交还）')
                            _HOLEV['ball'] = None
                            _e2 = _mob2.hole_cycle_edge()
                            print('[道具] P%d 切边 -> %s' % (_pk, _e2),
                                  flush=True)

                for _pk in (1, 2):
                    _cnt = v3_hub.buy1 if _pk == 1 else v3_hub.buy2
                    if not _mas_ev('cfm%d' % _pk, _cnt):
                        continue
                    # ★★ 2026-10-27 实体布置确认：E/小键盘* = 确定（不自动扣）
                    if _PPLACE['on'] and _PPLACE['who'] == _pk:
                        if _PPLACE.get('confirm'):
                            _okp, _msgp = _pplace_commit_now(_mob2, v3_world)
                            print('[布置] %s' % _msgp, flush=True)
                            if not _okp:
                                _item_msg_set('放不下：' + _msgp)
                        else:
                            _key = _pplace_key(_pk)
                            _item_msg_set('还没识别到新件——把实体件放到场区，'
                                          '黄框出现后按 %s' % _key)
                            print('[布置] P%d %s：还没有待确认的新件'
                                  % (_pk, _key), flush=True)
                        continue
                    # ★★ 2026-10-28 调整界面：E/小键盘* = 「开始本局」
                    if _ADJ['on']:
                        _adj_start(_MF['ob'], _pk, v3_world)
                        continue
                    if _OBSP['on'] and _OBSP['who'] == _pk:
                        # ★ 布置 PLACE v1：E 两段——第一下=定住弹窗；再一下=确定放置。
                        if not _OBSP['confirm']:
                            _OBSP['confirm'] = True
                            _item_msg_set('确认放置这个障碍？（点「确定」或再按 E）')
                            print('[布置] P%d 定住位置——等「确定」（W/S 可继续旋转）'
                                  % _pk, flush=True)
                        else:
                            _ok, _omsg = _obsp_commit(_mob2, v3_world, _OBST)
                            print('[布置] %s' % _omsg, flush=True)
                            _item_msg_set(_omsg if _ok else ('放不下：' + _omsg))
                            if _ok:
                                _shot_write(dict(t=round(time.time(), 3),
                                                 ok=True, why='item',
                                                 kind='item', seq=0,
                                                 msg=_omsg), player=_pk)
                                _obsp_clear()
                    elif _mob2.phase == 'EDIT' and _mob2.edit['player'] == _pk:
                        # ★ 2026-10-29 三步确认：E / P2 小键盘 * 逐步确认
                        _edit_do_stage_confirm(_mob2, v3_world, _pk)
                    elif _mob2.phase == 'HOLE' and _mob2.hole['player'] == _pk:
                        if _mob2.hole['stage'] == 'EDGE':
                            _ed2 = _mob2.hole['edge']
                            _len2 = 960.0 if _ed2 in ('top', 'bottom') else 540.0
                            _mob2.hole_to_fine(_len2 / 2.0)
                            print('[道具] 洞口边=%s 微调中（%s 10px/按；E 放置/ESC 取消）'
                                  % (_ed2, 'W/S' if _ed2 in ('left', 'right')
                                     else 'A/D'), flush=True)
                        else:
                            _ed3, _ps3 = _mob2.hole['edge'], float(_mob2.hole['pos'])
                            if _hole_commit(_mob2, v3_world):
                                _holev_clear()
                                print('[道具] %s（边=%s 位置=%.0f；target=0 演示口径）'
                                      % (_mob2.msg, _ed3, _ps3), flush=True)
                                _shot_write(dict(t=round(time.time(), 3), ok=True,
                                                 why='item', kind='item', seq=0,
                                                 msg='P%d 加洞口(%s %.0f)'
                                                     % (_pk, _ed3, _ps3)),
                                            player=_pk)
                            else:
                                print('[道具] 放不下：%s' % _mob2.msg, flush=True)
                                _item_msg_set(_mob2.msg)

                if _mas_ev('esc', v3_hub.esc):
                    if _PBUY['on']:
                        _pbu_resolve(_MF['ob'], False)
                    elif _ABALL['on']:
                        _msga = _aball_cancel(
                            _screen_out if screen_on else None)
                        print('[道具] ESC %s' % _msga, flush=True)
                        _item_msg_set(_msga)
                    elif _PPLACE['on']:
                        # ★★ 2026-10-29 用户实况（"传送门点选后改不了、卡死"）：
                        #   传送门先清**已点的一对门**，回到重新点选；再按 ESC 退出。
                        if (_PPLACE.get('kind') == 'portal'
                                and _PPLACE.get('pair')):
                            _PPLACE['pair'] = None
                            _PPLACE['cand'] = []
                            _PPLACE['confirm'] = False
                            _PPLACE['status'] = 'waiting'
                            _item_msg_set('已清除点选——重新点两扇绿门'
                                          '（再按 ESC 退出）')
                            print('[布置] ESC 清除已点绿门（继续摆放）',
                                  flush=True)
                        else:
                            # ★★ 2026-10-31 用户实况（"连按 ESC 也退不掉"）：
                            #   原来这里还有一档"候选已识别时先取消候选、再按才退出"——
                            #   但**候选是每 0.3s 实时识别的**（_pplace_check 每次都
                            #   把 confirm 置回 True）⇒ 清掉 0.3s 后又回来，玩家永远
                            #   按不到"退出"那一档（键盘/手机连按都退不掉）。
                            #   改成：ESC **一次到底**，直接退出（额度未扣）。
                            _pplace_clear()
                            _item_msg_set('已退出布置（额度未扣）')
                            print('[布置] ESC 退出实体布置（额度未扣）', flush=True)
                    elif _ADJ['on']:
                        # ★ 2026-10-28：调整界面 ESC -> 回商店（双方重新可买/可调）
                        _MF['ob'].back_to_shop()
                        _ADJ['on'] = False
                        _SHOPV['open'] = True
                        _item_msg_set('回到商店（继续购买/调整）')
                        print('[布置] ESC 退出调整界面 -> 回商店', flush=True)
                    elif _OBSP['on']:
                        # ★ 布置 PLACE v1：ESC 两段——弹窗中=收弹窗回跟随；跟随中=退出。
                        if _OBSP['confirm']:
                            _OBSP['confirm'] = False
                            _item_msg_set('弹窗已取消——继续移动位置（再按 ESC 退出）')
                        else:
                            _obsp_clear()
                            _item_msg_set('已退出布置（额度未扣）')
                    elif _mob2.phase == 'EDIT':
                        # ★ 2026-10-29 三步确认：ESC 每次退一步；选块阶段再 ESC=取消
                        _edit_do_back(_mob2)
                    elif _mob2.phase == 'HOLE':
                        # ★ 加洞口 v2：ESC 两段式——弹窗开着先回跟随，再按才整个取消
                        if _HOLEV['confirm']:
                            _HOLEV['confirm'] = False
                            print('[道具] 已取消确认弹窗——回到跟随（继续挪；'
                                  '再按 ESC = 整个取消）', flush=True)
                        else:
                            _mob2.end_hole(cancel=True)
                            _holev_clear()
                            print('[道具] %s' % _mob2.msg, flush=True)

                if _mob2.phase == 'EDIT' and _mob2.edit['player'] is not None:
                    _pkE = int(_mob2.edit['player'])
                    _ma = _EDC.pop('mouse_act', None)
                    if _ma == 'ok':
                        # 鼠标「确认」= 当前这一步确认（选块/方向/数值）
                        _edit_do_stage_confirm(_mob2, v3_world, _pkE)
                    elif _ma == 'no':
                        _edit_do_cancel(_mob2)
                    # ★★ 2026-10-29 用户实况：切块键（P1 A/D、P2 ←/→）在任何
                    #   阶段都有效——切块即回到选块阶段、需重新确认（不跳过确认）。
                    for _k2, _d2 in (('aup', +1), ('adn', -1)):
                        _cnt2 = getattr(v3_hub, '%s%d' % (_k2, _pkE))
                        if _mas_ev('%s%d' % (_k2, _pkE), _cnt2):
                            if _mob2.edit['stage'] != 'SELECT':
                                _mob2.edit['stage'] = 'SELECT'
                                _mob2.edit['txt'] = ''
                                print('[道具] P%d 切块 -> 回到选块（需重新确认）'
                                      % _pkE, flush=True)
                            _ix2 = _mob2.edit_next_block(
                                len(v3_world.blocks), _d2)
                            if _ix2 is not None:
                                print('[道具] P%d 选块 -> %d（B=%+.2f）'
                                      % (_pkE, _ix2 + 1,
                                         float(v3_world.blocks[_ix2].b)),
                                      flush=True)
                    # P1 W/S、P2 ↑/↓ = 定方向——**只有 DIR 阶段生效**（选块确认后）。
                    #   其它阶段也要消费计数器，否则退出编辑后对局瞄准会多走一格。
                    for _k2, _s2 in (('mup', +1), ('mdn', -1)):
                        _cnt2 = getattr(v3_hub, '%s%d' % (_k2, _pkE))
                        if not _mas_ev('%s%d' % (_k2, _pkE), _cnt2):
                            continue
                        if _mob2.edit['stage'] != 'DIR':
                            if _mob2.edit['stage'] == 'SELECT':
                                _item_msg_set('先确认选块（%s），方向才生效'
                                              % ('E' if _pkE == 1
                                                 else '小键盘 *'))
                            else:
                                _item_msg_set('已在数值阶段——ESC 可回方向')
                            continue
                        _sg2 = _mob2.edit_set_sign(_s2)
                        if _sg2 is not None:
                            print('[道具] P%d 方向 %s（块 %d）——'
                                  '按 %s 确认方向'
                                  % (_pkE, '+' if _sg2 > 0 else '-',
                                     int(_mob2.edit['idx']) + 1,
                                     'E' if _pkE == 1 else '小键盘 *'),
                                  flush=True)
                            _item_msg_set(
                                '方向 %s——按 %s 确认方向（ESC 返回选块）'
                                % ('+（出屏）' if _sg2 > 0 else '-（入屏）',
                                   'E' if _pkE == 1 else '小键盘 *'))
                    # ★ 2026-10-29：数字/退格**所有阶段都消费计数器**——否则
                    #   SELECT/DIR 阶段按过的数字会在进 VALUE 的那帧被"补打"。
                    _vin = (_mob2.edit['stage'] == 'VALUE')
                    for _i2 in range(10):
                        if _mas_ev('nd%d' % _i2,
                                   int(v3_hub.nd[_i2] or 0)) and _vin:
                            _mob2.edit_type(str(_i2))
                    if _mas_ev('nd7b', int(v3_hub.ppl2 or 0)) and _vin:
                        _mob2.edit_type('7')
                    if _mas_ev('nd8b', int(v3_hub.aball2 or 0)) and _vin:
                        _mob2.edit_type('8')
                    if _mas_ev('ndbk', int(v3_hub.nbksp or 0)) and _vin:
                        _mob2.edit_backspace()
                    if _mas_ev('nddot', int(v3_hub.sup2 or 0)) and _vin:
                        _mob2.edit_type('.')
                elif _mob2.phase == 'HOLE' and _mob2.hole['stage'] == 'FINE':
                    _opl = _mob2.hole['player']
                    _pfx = 1 if _opl == 1 else 2
                    _horiz = _mob2.hole['edge'] in ('top', 'bottom')
                    _mvs = (('aup', +10.0), ('adn', -10.0)) if _horiz \
                        else (('mup', +10.0), ('mdn', -10.0))
                    for _k2, _d2 in _mvs:
                        _cnt2 = getattr(v3_hub, '%s%d' % (_k2, _pfx))
                        if _mas_ev('%s%d' % (_k2, _pfx), _cnt2):
                            _hi2 = (960.0 if _horiz else 540.0) - 50.0
                            _np2 = _mob2.hole_adjust(_d2, 50.0, _hi2)
                            print('[道具] 洞口 pos=%.0f（%s）'
                                  % (_np2, '可放' if _hole_valid(
                                      v3_world, _mob2.hole['edge'], _np2)
                                     else '★放不下'), flush=True)

                # ---- ★★ 2026-10-15 加洞口 v2：鼠标跟随（对话5 死前定稿）--------
                #   进入 HOLE 后**鼠标一动即接管**（与进入点差 >8px）：最近边选边、
                #   沿边滑动定位置——每帧从鼠标位置重算 edge+pos（含尺寸换算，见
                #   _hole_from_mouse）。弹窗开着（confirm）时位置定住，这里只记光标。
                #   没动过鼠标 = 不碰状态，老键盘流程原样。离开 HOLE 一律归零。
                # ★ 2026-10-19 布置 PLACE v1：摆放态鼠标跟随（直映射——与
                #   _build_obsp_view 的画法成对：1:1 居中，偏移 (w-960)/2,(h-540)/2；
                #   与 _hole_side_from_canvas 同款口径）。一动才接管。
                if _OBSP['on'] and _MF['ob'] is not None \
                        and _MF['ob'].phase == 'PREP' and v3_hub is not None:
                    _mx4, _my4 = int(v3_hub.mx), int(v3_hub.my)
                    if (not _OBSP['mouse']
                            and (abs(_mx4 - _OBSP['m0'][0]) > 8
                                 or abs(_my4 - _OBSP['m0'][1]) > 8)):
                        _OBSP['mouse'] = True
                    if _OBSP['mouse'] and not _OBSP['confirm']:
                        _ox4 = (int(v3_pump.width) - 960) // 2
                        _oy4 = (int(v3_pump.height) - 540) // 2
                        _OBSP['cx'] = max(0.0, min(960.0, float(_mx4 - _ox4)))
                        _OBSP['cy'] = max(0.0, min(540.0, float(_my4 - _oy4)))
                if (_mob2.phase == 'HOLE'
                        and _HOLEV['who'] == _mob2.hole['player']):
                    _HOLEV['last'] = (int(v3_hub.mx), int(v3_hub.my))
                    if v3_pump is not None:
                        _HOLEV['pw'], _HOLEV['ph'] = v3_pump.width, v3_pump.height
                        if not _HOLEV['confirm']:
                            if not _HOLEV['mouse']:
                                _dvh = (abs(_HOLEV['last'][0] - _HOLEV['m0'][0])
                                        + abs(_HOLEV['last'][1] - _HOLEV['m0'][1]))
                                if _dvh > 8:
                                    _HOLEV['mouse'] = True
                                    _HOLEV['ball'] = None
                                    print('[道具] P%d 加洞口：鼠标接管——'
                                          '移动鼠标选边/滑动，左键点住→弹窗，'
                                          'E 确定 ESC 取消'
                                          % _mob2.hole['player'], flush=True)
                            if _HOLEV['mouse']:
                                try:
                                    # ★ 2026-10-16：瞄准图 -> 直映射（用户实况
                                    #   "左边一部分吸附不到"的根因就是这里还在走
                                    #   相机标定链）
                                    _ed6, _ps6 = _hole_side_from_canvas(
                                        _HOLEV['last'][0], _HOLEV['last'][1],
                                        v3_pump.width, v3_pump.height)
                                    if (_ed6 != _mob2.hole['edge']
                                            or abs(_ps6 - float(_mob2.hole['pos']))
                                            > 0.5
                                            or _mob2.hole['stage'] != 'FINE'):
                                        _mob2.hole_set_pos(_ed6, _ps6)
                                except Exception:
                                    pass
                else:
                    if (_HOLEV['who'] is not None or _HOLEV['confirm']
                            or _HOLEV['mouse']):
                        _holev_clear()

                # ---- ★★ 2026-10-15 加洞口 v2：手机俯视图点位置（游戏坐标直达）--
                #   数据源 = v3_input 的 p{N}_hopos 计数 + p{N}_hx/hy（serve 的
                #   /hole?act=pos 写）——与键盘/鼠标同一套"读数上升沿 + 文件重建
                #   只对基准"的纪律（_mas_ev 同款；键名已进 _MAS 表）。
                for _pkh in (1, 2):
                    _cnth = int(getattr(v3_hub, 'hopos%d' % _pkh, 0) or 0)
                    if not _mas_ev('hopos%d' % _pkh, _cnth):
                        continue
                    if _mob2.phase == 'HOLE' and _HOLEV['who'] == _pkh:
                        _gxh = float(getattr(v3_hub, 'hx%d' % _pkh, 0.0) or 0.0)
                        _gyh = float(getattr(v3_hub, 'hy%d' % _pkh, 0.0) or 0.0)
                        _HOLEV['ball'] = None
                        _edh, _psh = _hole_from_game(_gxh, _gyh)
                        _hole_apply_pos(_mob2, _edh, _psh, _MF['mod'],
                                        v3_world, src='手机点位置')
                    else:
                        print('[道具] 手机点了位置，但不在加洞口（忽略）',
                              flush=True)

                # ---- ★★ 2026-10-16 粒子引擎（--pe）：B=P1 / N=P2 放一簇粒子 ----
                for _pkp, _pcn in ((1, v3_ball1), (2, v3_ball2)):
                    _cntp = int(getattr(v3_hub, 'pe%d' % _pkp, 0) or 0)
                    if not _mas_ev('pe%d' % _pkp, _cntp):
                        continue
                    if not _PEB['on']:
                        print('[粒子] B/N：引擎没开（加 --pe 且用带 pe_axi 的 bit）',
                              flush=True)
                        continue
                    _src = None
                    try:
                        _ptp = next((t for t in (_tracks or [])
                                     if getattr(t, 'no', None) == _pcn), None)
                        if _ptp is not None and v3_mod is not None:
                            _src = v3_mod.cam_to_game(v3_H, _ptp.sx, _ptp.sy)[:2]
                    except Exception:
                        _src = None
                    if _src is None:            # 没跟踪到球 -> 本侧半场中点兜底
                        _src = (200.0, 270.0) if _pkp == 1 else (760.0, 270.0)
                    # ★ 2026-10-19 实况：双方控同一颗球时，红蓝风暴同点生成会
                    #   瞬间互相湮灭（看起来"按 BN 没反应"）→ 按玩家左右错开。
                    _sx2 = float(_src[0]) + (-60.0 if _pkp == 1 else 60.0)
                    _sy2 = float(_src[1]) + (-30.0 if _pkp == 1 else 30.0)
                    # ★ 2026-10-19 观感：球贴边时风暴几帧就出洞 → 压进场区内部
                    _sx2 = max(120.0, min(840.0, _sx2))
                    _sy2 = max(90.0, min(450.0, _sy2))
                    _pe_spawn_storm(_PEB, _sx2, _sy2,
                                    n=4, chg=(1 if _pkp == 1 else -1))
                    print('[粒子] P%d 风暴：4 颗从 (%.0f,%.0f) 入场'
                          '（PL 并行物理）' % (_pkp, _sx2, _sy2),
                          flush=True)
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
